mosschief/toddler_bed/output/CUT_LIST.md

# Cut lists

All sizes in inches, generated by `generate.py`.

### Floor bed, side exit

Mattress on the floor, exit toward the foot end like the reference photo.

| Part | Qty | Size (W x H) | Notes |
|---|---:|---|---|
| Front panel A | 1 | 45 1/4" x 14" | knob half |
| Front panel B | 1 | 20" x 14" | socket half |
| Box side (wall) | 2 | 28 1/8" x 12 1/4" | against the nook wall, 1 per box |
| Box side (mattress) | 2 | 28 1/8" x 12 1/4" | faces the mattress; hand cut-out to open the lid |
| Box back | 2 | 5 3/4" x 12 1/4" | screw through into wall studs |
| Box front | 2 | 5 3/4" x 12 1/4" | against the back of the front panel; 4 bolts into it |
| Box floor | 2 | 5 3/4" x 25 1/2" | sits 1" off the floor |
| Box lid | 2 | 5 3/4" x 27 5/8" | piano hinge along the long wall-side edge |

- **Panels:** 2 pieces of 4'x4' (1 x 4'x8' sheet(s) of 3/4" plywood, each cut in half)
- **Heights from floor:** mattress top 5", rail top 14", box lids 13", exit sill 4"
- **Exit opening:** 38" to 54" from the head wall; panel halves join at 44"
- **Head/foot boxes:** 5 3/4" wide outside, 4 1/4" inside, 27 3/4" deep

### Floor bed, side exit, one box

Same as the side-exit bed, but with one wider box at the head end and the mattress against the foot wall.

| Part | Qty | Size (W x H) | Notes |
|---|---:|---|---|
| Front panel A | 1 | 45 1/4" x 14" | knob half |
| Front panel B | 1 | 20" x 14" | socket half |
| Box side (wall) | 1 | 28 1/8" x 12 1/4" | against the nook wall, 1 per box |
| Box side (mattress) | 1 | 28 1/8" x 12 1/4" | faces the mattress; hand cut-out to open the lid |
| Box back | 1 | 10 3/4" x 12 1/4" | screw through into wall studs |
| Box front | 1 | 10 3/4" x 12 1/4" | against the back of the front panel; 4 bolts into it |
| Box floor | 1 | 10 3/4" x 25 1/2" | sits 1" off the floor |
| Box lid | 1 | 10 3/4" x 27 5/8" | piano hinge along the long wall-side edge |
| Foot wall liner | 1 | 28 1/8" x 13" | screw to the foot wall studs; runs into the panel groove |
| Foot block | 1 | 1 1/2" x 6 1/4" | above the mattress; glue + 2 screws to the liner, 2 bolts into the panel |

- **Panels:** 2 pieces of 4'x4' (1 x 4'x8' sheet(s) of 3/4" plywood, each cut in half)
- **Heights from floor:** mattress top 5", rail top 14", box lids 13", exit sill 4"
- **Exit opening:** 38" to 54" from the head wall; panel halves join at 44"
- **Head box:** 10 3/4" wide outside, 9 1/4" inside, 27 3/4" deep; no foot box (mattress against a liner on the foot wall)

### Floor bed, side exit, one box, flush tops

The one-box bed with the box lid and the foot board raised flush with the top of the front panel.

| Part | Qty | Size (W x H) | Notes |
|---|---:|---|---|
| Front panel A | 1 | 45 1/4" x 14" | knob half |
| Front panel B | 1 | 20" x 14" | socket half |
| Box side (wall) | 1 | 28 1/8" x 13 1/4" | against the nook wall, 1 per box |
| Box side (mattress) | 1 | 28 1/8" x 13 1/4" | faces the mattress; hand cut-out to open the lid |
| Box back | 1 | 10 3/4" x 13 1/4" | screw through into wall studs |
| Box front | 1 | 10 3/4" x 13 1/4" | against the back of the front panel; 4 bolts into it |
| Box floor | 1 | 10 3/4" x 25 1/2" | sits 1" off the floor |
| Box lid | 1 | 10 3/4" x 27 5/8" | piano hinge along the long wall-side edge |
| Foot wall liner | 1 | 28 1/8" x 14" | screw to the foot wall studs; runs into the panel groove |
| Foot block | 1 | 1 1/2" x 7 1/4" | above the mattress; glue + 2 screws to the liner, 2 bolts into the panel |

- **Panels:** 2 pieces of 4'x4' (1 x 4'x8' sheet(s) of 3/4" plywood, each cut in half)
- **Heights from floor:** mattress top 5", rail top 14", box lids 14", exit sill 4"
- **Exit opening:** 38" to 54" from the head wall; panel halves join at 44"
- **Head box:** 10 3/4" wide outside, 9 1/4" inside, 27 3/4" deep; no foot box (mattress against a liner on the foot wall)

### Floor bed, side exit, one box, flowers

The flush-top one-box bed with flower cut-outs in the rail instead of slots.

| Part | Qty | Size (W x H) | Notes |
|---|---:|---|---|
| Front panel A | 1 | 45 1/4" x 14" | knob half |
| Front panel B | 1 | 20" x 14" | socket half |
| Box side (wall) | 1 | 28 1/8" x 13 1/4" | against the nook wall, 1 per box |
| Box side (mattress) | 1 | 28 1/8" x 13 1/4" | faces the mattress; hand cut-out to open the lid |
| Box back | 1 | 10 3/4" x 13 1/4" | screw through into wall studs |
| Box front | 1 | 10 3/4" x 13 1/4" | against the back of the front panel; 4 bolts into it |
| Box floor | 1 | 10 3/4" x 25 1/2" | sits 1" off the floor |
| Box lid | 1 | 10 3/4" x 27 5/8" | piano hinge along the long wall-side edge |
| Foot wall liner | 1 | 28 1/8" x 14" | screw to the foot wall studs; runs into the panel groove |
| Foot block | 1 | 1 1/2" x 7 1/4" | above the mattress; glue + 2 screws to the liner, 2 bolts into the panel |

- **Panels:** 2 pieces of 4'x4' (1 x 4'x8' sheet(s) of 3/4" plywood, each cut in half)
- **Heights from floor:** mattress top 5", rail top 14", box lids 14", exit sill 4"
- **Exit opening:** 38" to 54" from the head wall; panel halves join at 44"
- **Head box:** 10 3/4" wide outside, 9 1/4" inside, 27 3/4" deep; no foot box (mattress against a liner on the foot wall)

### Floor bed, side exit, box at the foot

The flush-top one-box bed with the box moved to the foot end and the mattress against the head wall; the exit sits just before the box.

| Part | Qty | Size (W x H) | Notes |
|---|---:|---|---|
| Front panel A | 1 | 42 1/4" x 14" | knob half |
| Front panel B | 1 | 23" x 14" | socket half |
| Box side (wall) | 1 | 28 1/8" x 13 1/4" | against the nook wall, 1 per box |
| Box side (mattress) | 1 | 28 1/8" x 13 1/4" | faces the mattress; hand cut-out to open the lid |
| Box back | 1 | 10 3/4" x 13 1/4" | screw through into wall studs |
| Box front | 1 | 10 3/4" x 13 1/4" | against the back of the front panel; 4 bolts into it |
| Box floor | 1 | 10 3/4" x 25 1/2" | sits 1" off the floor |
| Box lid | 1 | 10 3/4" x 27 5/8" | piano hinge along the long wall-side edge |
| Head wall liner | 1 | 28 1/8" x 14" | screw to the head wall studs; runs into the panel groove |
| Head block | 1 | 1 1/2" x 7 1/4" | above the mattress; glue + 2 screws to the liner, 2 bolts into the panel |

- **Panels:** 2 pieces of 4'x4' (1 x 4'x8' sheet(s) of 3/4" plywood, each cut in half)
- **Heights from floor:** mattress top 5", rail top 14", box lids 14", exit sill 4"
- **Exit opening:** 35" to 51" from the head wall; panel halves join at 41"
- **Foot box:** 10 3/4" wide outside, 9 1/4" inside, 27 3/4" deep; no head box (mattress against a liner on the head wall)

### Floor bed, side exit, box at the foot, trees

The foot-box bed with a staggered row of pine-tree cut-outs instead of slots.

| Part | Qty | Size (W x H) | Notes |
|---|---:|---|---|
| Front panel A | 1 | 42 1/4" x 14" | knob half |
| Front panel B | 1 | 23" x 14" | socket half |
| Box side (wall) | 1 | 28 1/8" x 13 1/4" | against the nook wall, 1 per box |
| Box side (mattress) | 1 | 28 1/8" x 13 1/4" | faces the mattress; hand cut-out to open the lid |
| Box back | 1 | 10 3/4" x 13 1/4" | screw through into wall studs |
| Box front | 1 | 10 3/4" x 13 1/4" | against the back of the front panel; 4 bolts into it |
| Box floor | 1 | 10 3/4" x 25 1/2" | sits 1" off the floor |
| Box lid | 1 | 10 3/4" x 27 5/8" | piano hinge along the long wall-side edge |
| Head wall liner | 1 | 28 1/8" x 14" | screw to the head wall studs; runs into the panel groove |
| Head block | 1 | 1 1/2" x 7 1/4" | above the mattress; glue + 2 screws to the liner, 2 bolts into the panel |

- **Panels:** 2 pieces of 4'x4' (1 x 4'x8' sheet(s) of 3/4" plywood, each cut in half)
- **Heights from floor:** mattress top 5", rail top 14", box lids 14", exit sill 4"
- **Exit opening:** 35" to 51" from the head wall; panel halves join at 41"
- **Foot box:** 10 3/4" wide outside, 9 1/4" inside, 27 3/4" deep; no head box (mattress against a liner on the head wall)

### Floor bed, side exit, box at the foot, ferns

The foot-box bed with a row of fern-frond cut-outs instead of slots.

| Part | Qty | Size (W x H) | Notes |
|---|---:|---|---|
| Front panel A | 1 | 42 1/4" x 14" | knob half |
| Front panel B | 1 | 23" x 14" | socket half |
| Box side (wall) | 1 | 28 1/8" x 13 1/4" | against the nook wall, 1 per box |
| Box side (mattress) | 1 | 28 1/8" x 13 1/4" | faces the mattress; hand cut-out to open the lid |
| Box back | 1 | 10 3/4" x 13 1/4" | screw through into wall studs |
| Box front | 1 | 10 3/4" x 13 1/4" | against the back of the front panel; 4 bolts into it |
| Box floor | 1 | 10 3/4" x 25 1/2" | sits 1" off the floor |
| Box lid | 1 | 10 3/4" x 27 5/8" | piano hinge along the long wall-side edge |
| Head wall liner | 1 | 28 1/8" x 14" | screw to the head wall studs; runs into the panel groove |
| Head block | 1 | 1 1/2" x 7 1/4" | above the mattress; glue + 2 screws to the liner, 2 bolts into the panel |

- **Panels:** 2 pieces of 4'x4' (1 x 4'x8' sheet(s) of 3/4" plywood, each cut in half)
- **Heights from floor:** mattress top 5", rail top 14", box lids 14", exit sill 4"
- **Exit opening:** 35" to 51" from the head wall; panel halves join at 41"
- **Foot box:** 10 3/4" wide outside, 9 1/4" inside, 27 3/4" deep; no head box (mattress against a liner on the head wall)

### Floor bed, centre exit

Mattress on the floor, exit in the middle; the two panel halves are mirror-length and join in the low sill.

| Part | Qty | Size (W x H) | Notes |
|---|---:|---|---|
| Front panel A | 1 | 33 1/4" x 14" | knob half |
| Front panel B | 1 | 32" x 14" | socket half |
| Box side (wall) | 2 | 28 1/8" x 12 1/4" | against the nook wall, 1 per box |
| Box side (mattress) | 2 | 28 1/8" x 12 1/4" | faces the mattress; hand cut-out to open the lid |
| Box back | 2 | 5 3/4" x 12 1/4" | screw through into wall studs |
| Box front | 2 | 5 3/4" x 12 1/4" | against the back of the front panel; 4 bolts into it |
| Box floor | 2 | 5 3/4" x 25 1/2" | sits 1" off the floor |
| Box lid | 2 | 5 3/4" x 27 5/8" | piano hinge along the long wall-side edge |

- **Panels:** 2 pieces of 4'x4' (1 x 4'x8' sheet(s) of 3/4" plywood, each cut in half)
- **Heights from floor:** mattress top 5", rail top 14", box lids 13", exit sill 4"
- **Exit opening:** 24" to 40" from the head wall; panel halves join at 32"
- **Head/foot boxes:** 5 3/4" wide outside, 4 1/4" inside, 27 3/4" deep

### Raised bed over IKEA drawers

Mattress on a plywood deck over two small IKEA HEMNES underbed boxes, with plywood drawer faces; centre exit.

| Part | Qty | Size (W x H) | Notes |
|---|---:|---|---|
| Front panel A | 1 | 33 1/4" x 22 5/8" | knob half |
| Front panel B | 1 | 32" x 22 5/8" | socket half |
| Box side (wall) | 2 | 28 1/8" x 20 7/8" | against the nook wall, 1 per box |
| Box side (mattress) | 2 | 28 1/8" x 20 7/8" | faces the mattress; hand cut-out to open the lid |
| Box back | 2 | 5 3/4" x 20 7/8" | screw through into wall studs |
| Box front | 2 | 5 3/4" x 20 7/8" | against the back of the front panel; 4 bolts into it |
| Box floor | 2 | 5 3/4" x 25 1/2" | sits 1" off the floor |
| Box lid | 2 | 5 3/4" x 27 5/8" | piano hinge along the long wall-side edge |
| Deck ledger (box side) | 2 | 27 3/4" x 1 1/2" | screwed to the mattress-side face of each box |
| Deck | 2 | 26 1/4" x 27 3/4" | mattress platform, two halves |
| Centre divider | 1 | 28 1/2" x 7 7/8" | front edge flush with the panel face |
| Deck ledger (wall) | 2 | 25 7/8" x 1 1/2" | screw into wall studs at the back |
| Drawer face | 2 | 25 5/8" x 7 3/8" | screw to the IKEA box from inside |

- **Panels:** 5 pieces of 4'x4' (3 x 4'x8' sheet(s) of 3/4" plywood, each cut in half)
- **Heights from floor:** mattress top 13 5/8", rail top 22 5/8", box lids 21 5/8", exit sill 12 5/8"
- **Exit opening:** 24" to 40" from the head wall; panel halves join at 32"
- **Head/foot boxes:** 5 3/4" wide outside, 4 1/4" inside, 27 3/4" deep
