mosschief/toddler_bed/hardware/lid_hinges/lid_hidden_hinge_end_view.png

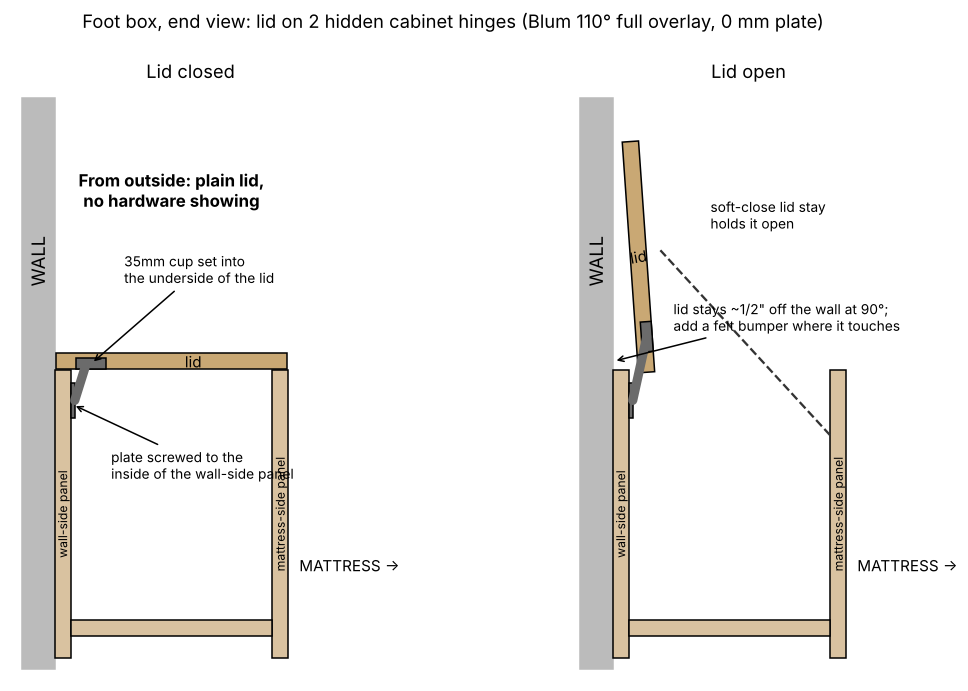
hardware/lid_hinges/lid_hidden_hinge_end_view.png
