mosschief/toddler_bed/hardware/lid_hinges/lid_hinge_cups.png

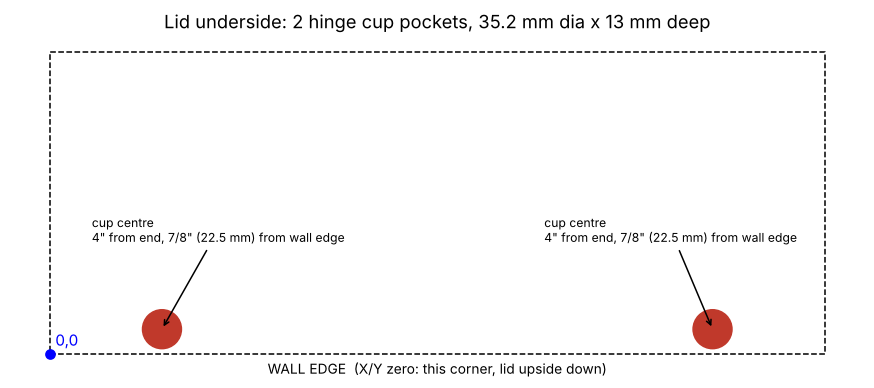
hardware/lid_hinges/lid_hinge_cups.png
