mosschief/toddler_bed/output/v1_side_exit/dogbone_detail.png

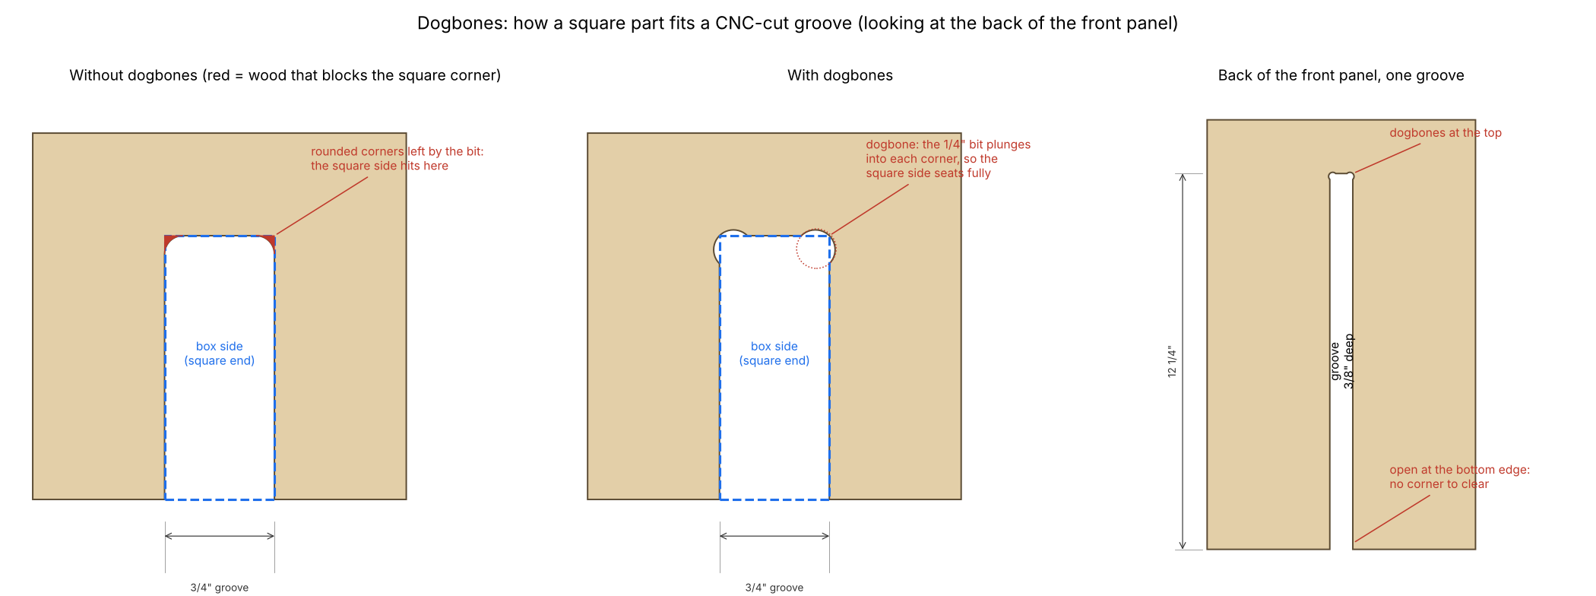
output/v1_side_exit/dogbone_detail.png
