mosschief/toddler_bed/hardware/lid_hinges/lid_hinge_cups.dxf

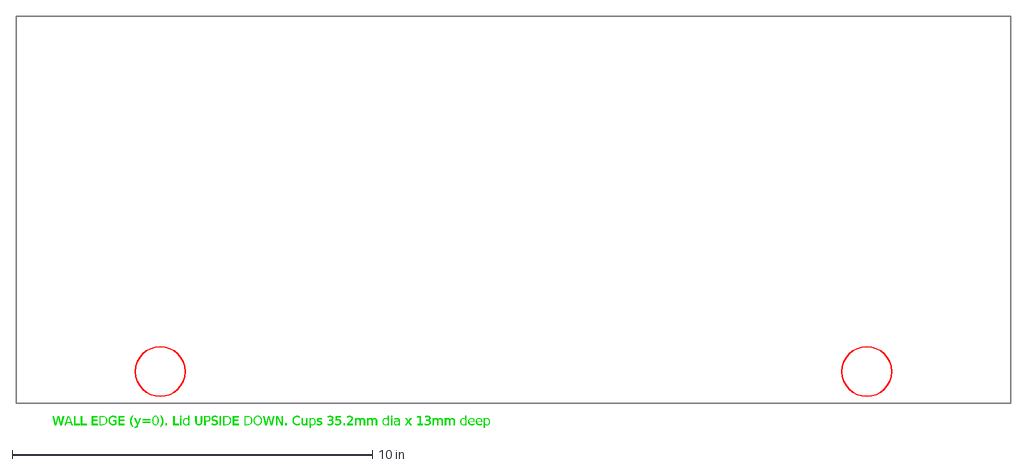
[picture p42: CAD file, 2026-10-31]
hardware/lid_hinges/lid_hinge_cups.dxf
WALL EDGE (y=0). Lid UPSIDE DOWN. Cups 35.2mm dia x 13mm deep
