mosschief/toddler_bed/output/v1_side_exit/parts/front_panel_b.dxf

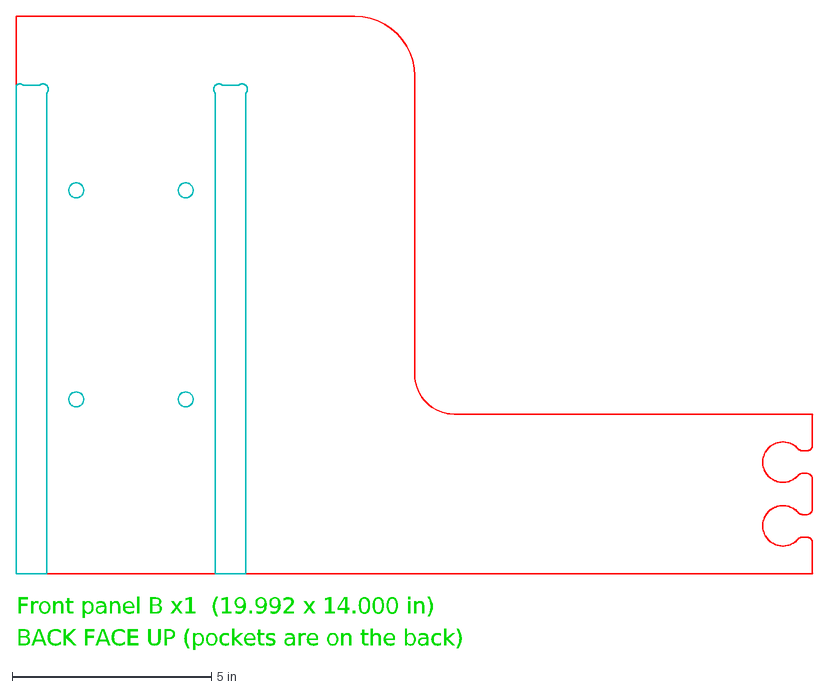
[picture p43: CAD file, 2026-10-17]
output/v1_side_exit/parts/front_panel_b.dxf
BACK FACE UP (pockets are on the back)
Front panel B x1 (19.992 x 14.000 in)
