mosschief/toddler_bed/output/v1_side_exit/v1_side_exit.step

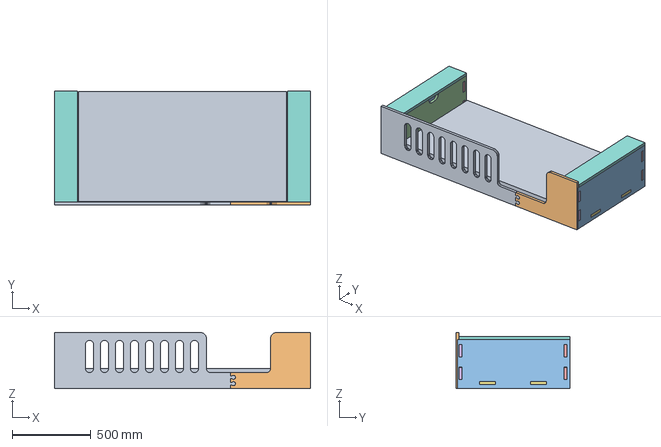
[picture p44: CAD file, 2026-10-17]
output/v1_side_exit/v1_side_exit.step
1625.6 x 723.9 x 355.6 mm
