mosschief/toddler_bed/output/v1b_side_exit_one_box/parts/box_front.dxf

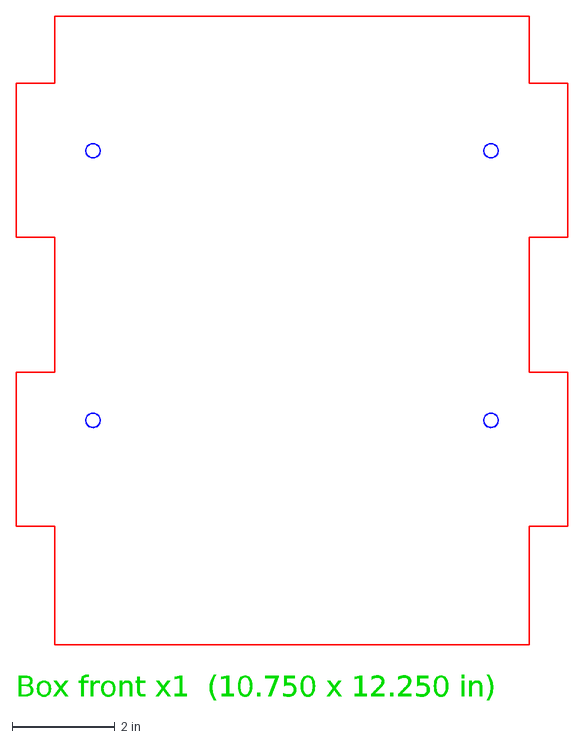
[picture p45: CAD file, 2026-10-17]
output/v1b_side_exit_one_box/parts/box_front.dxf
Box front x1 (10.750 x 12.250 in)
