mosschief/toddler_bed/output/v1b_side_exit_one_box/v1b_side_exit_one_box.step

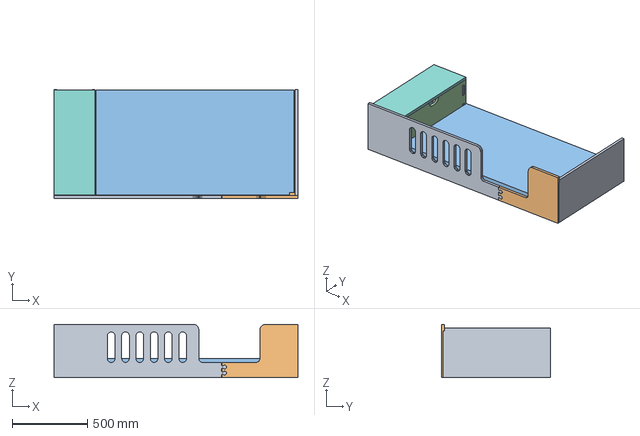
[picture p46: CAD file, 2026-10-17]
output/v1b_side_exit_one_box/v1b_side_exit_one_box.step
1625.6 x 723.9 x 355.6 mm
