mosschief/toddler_bed/output/v1c_side_exit_one_box_flush/v1c_side_exit_one_box_flush.step

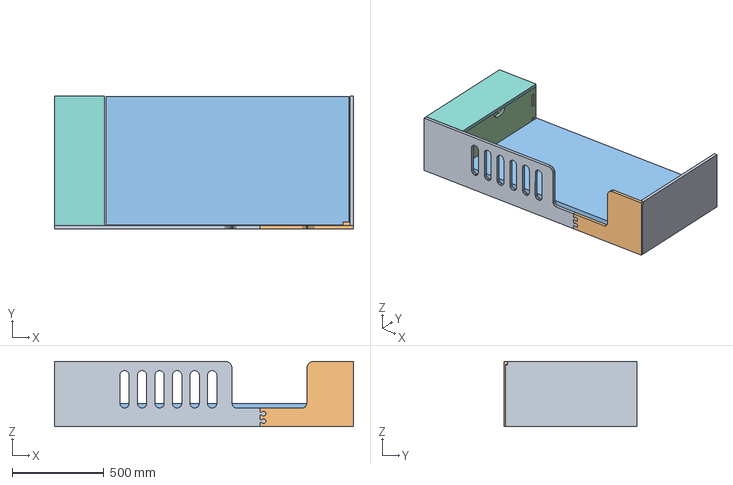
[picture p47: CAD file, 2026-10-17]
output/v1c_side_exit_one_box_flush/v1c_side_exit_one_box_flush.step
1625.6 x 723.9 x 355.6 mm
