mosschief/toddler_bed/output/v1d_side_exit_one_box_flowers/parts/box_side_wall.dxf

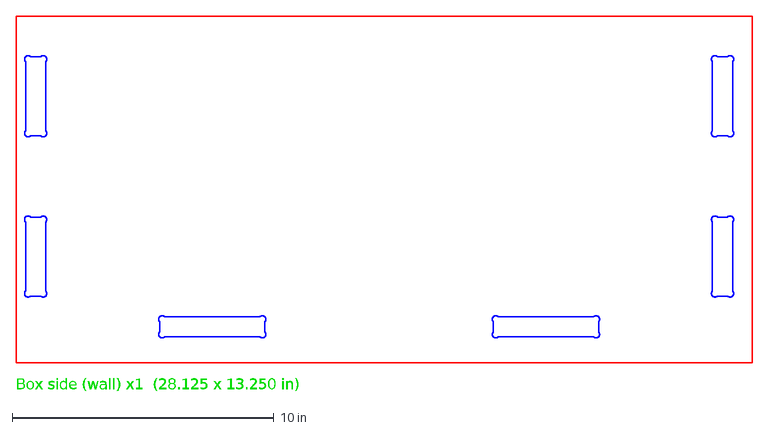
[picture p48: CAD file, 2026-10-17]
output/v1d_side_exit_one_box_flowers/parts/box_side_wall.dxf
Box side (wall) x1 (28.125 x 13.250 in)
