mosschief/toddler_bed/output/v1e_side_exit_foot_box/v1e_side_exit_foot_box.step

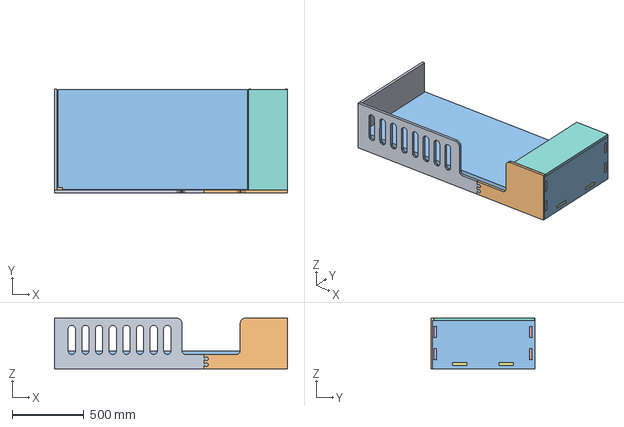
[picture p50: CAD file, 2026-10-17]
output/v1e_side_exit_foot_box/v1e_side_exit_foot_box.step
1625.6 x 723.9 x 355.6 mm
