mosschief/toddler_bed/output/v1f_side_exit_foot_box_trees/parts/box_lid.dxf

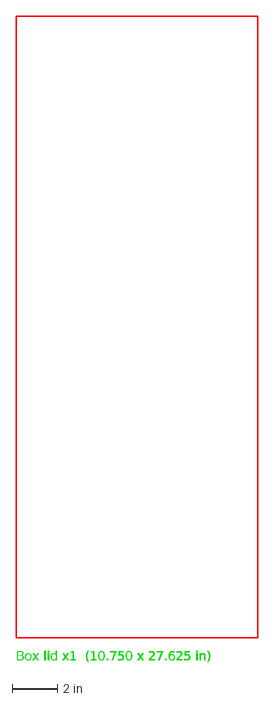
[picture p51: CAD file, 2026-10-17]
output/v1f_side_exit_foot_box_trees/parts/box_lid.dxf
Box lid x1 (10.750 x 27.625 in)
