mosschief/toddler_bed/output/v1g_side_exit_foot_box_ferns/parts/box_back.dxf

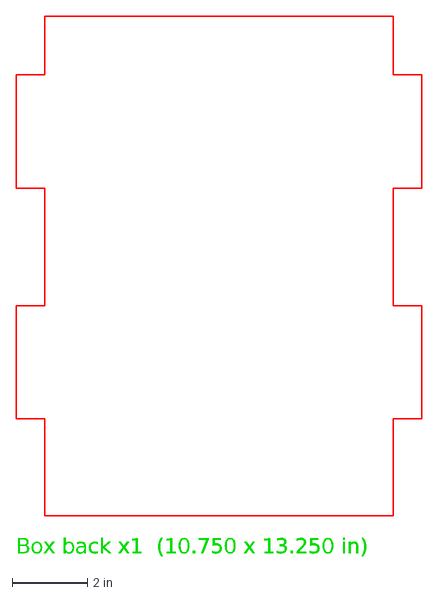
[picture p52: CAD file, 2026-10-17]
output/v1g_side_exit_foot_box_ferns/parts/box_back.dxf
Box back x1 (10.750 x 13.250 in)
