mosschief/toddler_bed/output/v1g_side_exit_foot_box_ferns/v1g_side_exit_foot_box_ferns.step

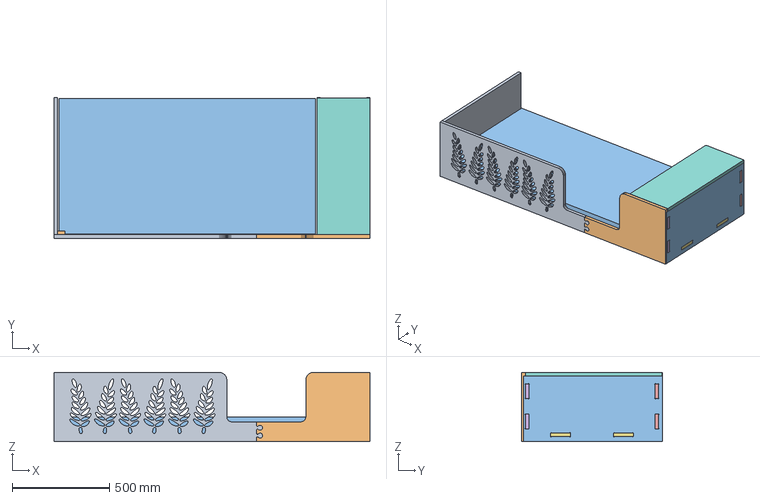
[picture p53: CAD file, 2026-10-17]
output/v1g_side_exit_foot_box_ferns/v1g_side_exit_foot_box_ferns.step
1625.6 x 723.9 x 355.6 mm
