mosschief/toddler_bed/output/v2_center_exit/parts/box_front.dxf

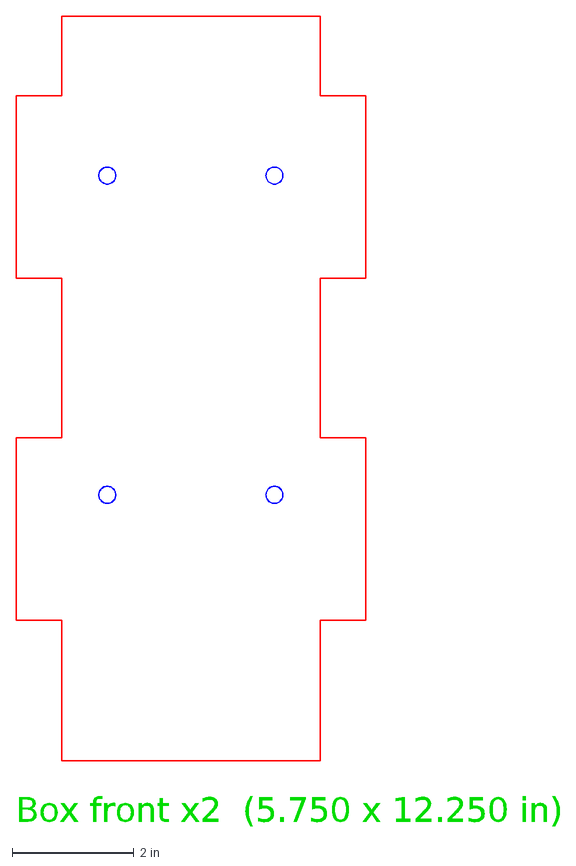
[picture p54: CAD file, 2026-10-17]
output/v2_center_exit/parts/box_front.dxf
Box front x2 (5.750 x 12.250 in)
