mosschief/toddler_bed/output/v3_raised_drawers/parts/box_side_wall.dxf

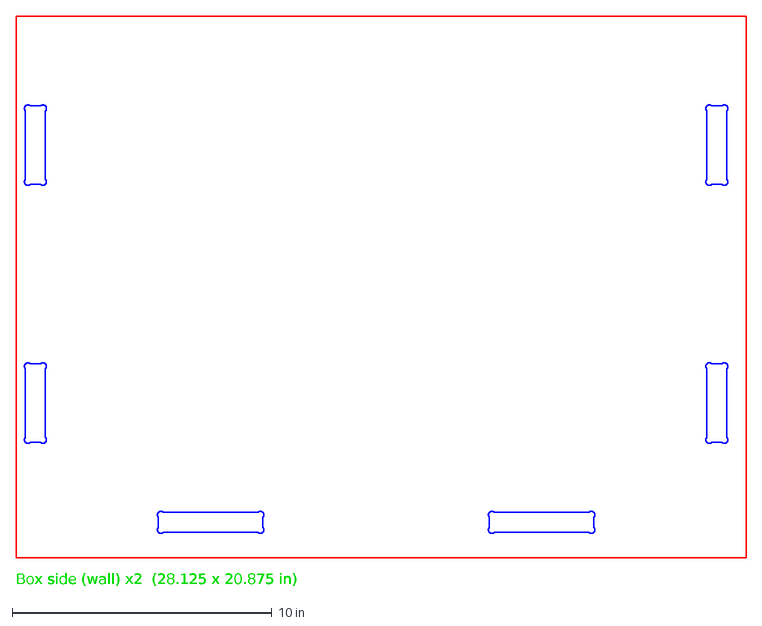
[picture p55: CAD file, 2026-10-17]
output/v3_raised_drawers/parts/box_side_wall.dxf
Box side (wall) x2 (28.125 x 20.875 in)
