mosschief/toddler_bed/output/v1b_side_exit_one_box/parts/foot_wall_liner.dxf

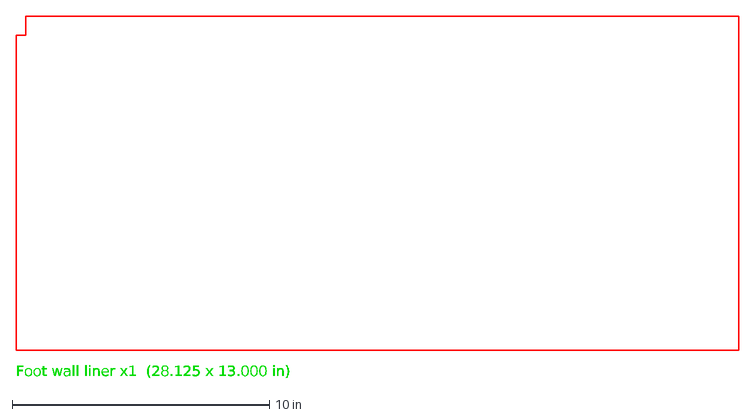
[picture p57: CAD file, 2026-10-17]
output/v1b_side_exit_one_box/parts/foot_wall_liner.dxf
Foot wall liner x1 (28.125 x 13.000 in)
