mosschief/toddler_bed/output/v1e_side_exit_foot_box/parts/box_side_wall.dxf

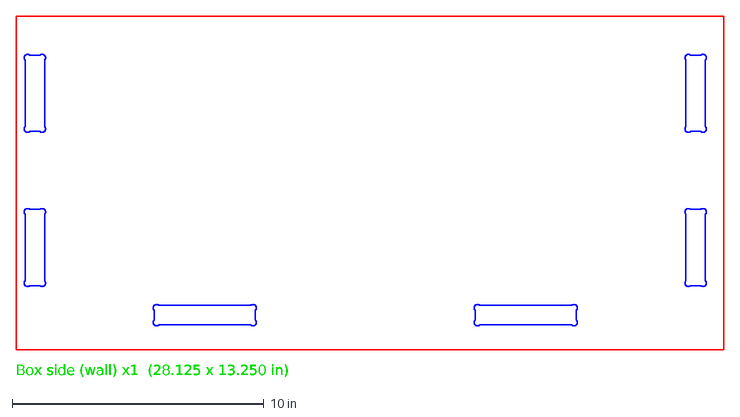
[picture p59: CAD file, 2026-10-17]
output/v1e_side_exit_foot_box/parts/box_side_wall.dxf
Box side (wall) x1 (28.125 x 13.250 in)
