mosschief/toddler_bed/output/v1f_side_exit_foot_box_trees/parts/box_side_mattress.dxf

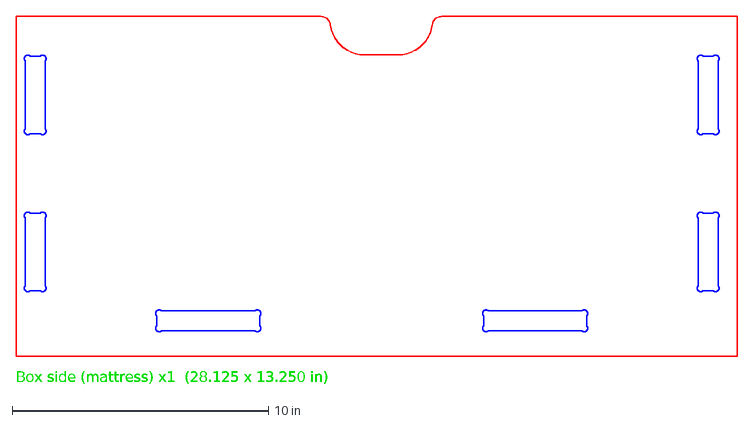
[picture p60: CAD file, 2026-10-17]
output/v1f_side_exit_foot_box_trees/parts/box_side_mattress.dxf
Box side (mattress) x1 (28.125 x 13.250 in)
