mosschief/toddler_bed/output/v2_center_exit/parts/front_panel_b.dxf

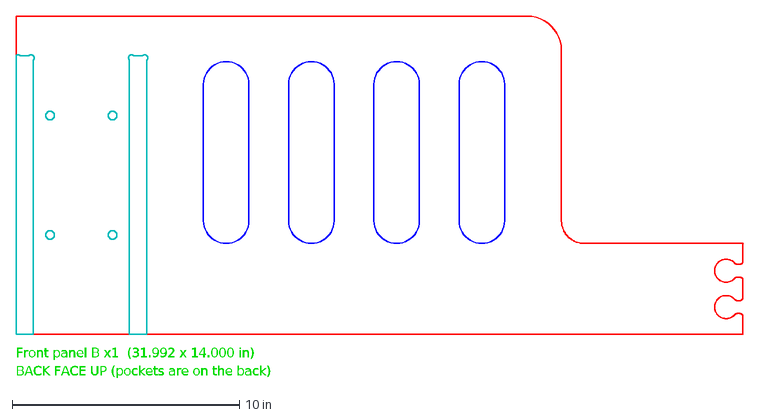
[picture p62: CAD file, 2026-10-17]
output/v2_center_exit/parts/front_panel_b.dxf
BACK FACE UP (pockets are on the back)
Front panel B x1 (31.992 x 14.000 in)
