mosschief/toddler_bed/output/v3_raised_drawers/parts/box_back.dxf

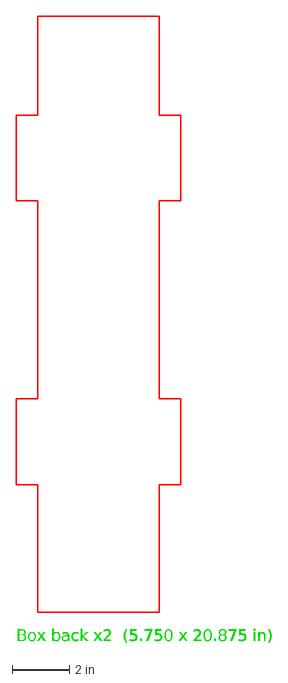
[picture p63: CAD file, 2026-10-17]
output/v3_raised_drawers/parts/box_back.dxf
Box back x2 (5.750 x 20.875 in)
