mosschief/toddler_bed/output/v1_side_exit/parts/box_floor.dxf

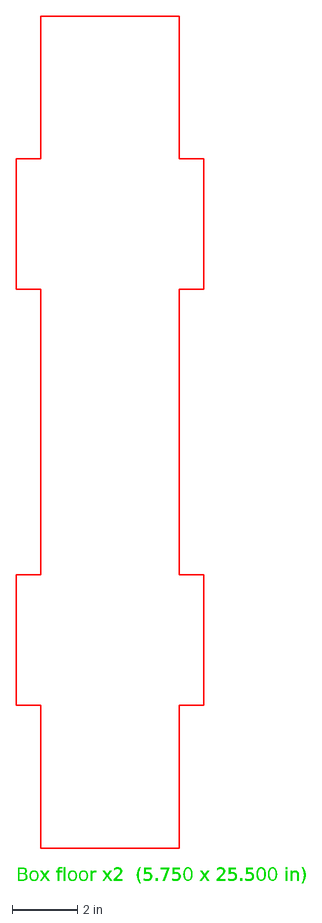
[picture p64: CAD file, 2026-10-17]
output/v1_side_exit/parts/box_floor.dxf
Box floor x2 (5.750 x 25.500 in)
