mosschief/toddler_bed/output/v1d_side_exit_one_box_flowers/parts/front_panel_b.dxf

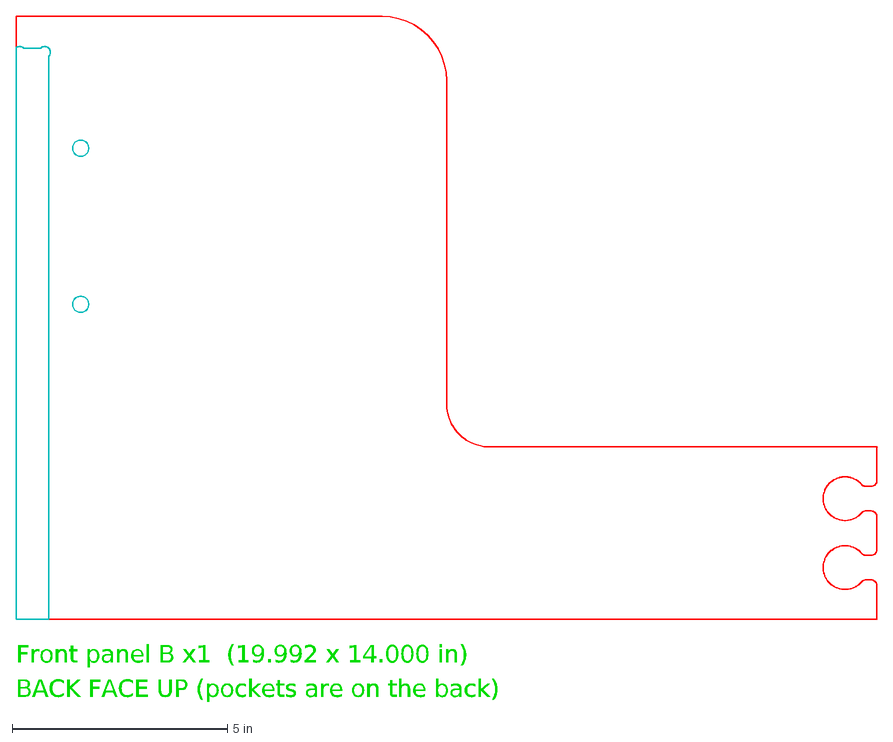
[picture p67: CAD file, 2026-10-17]
output/v1d_side_exit_one_box_flowers/parts/front_panel_b.dxf
BACK FACE UP (pockets are on the back)
Front panel B x1 (19.992 x 14.000 in)
