mosschief/toddler_bed/output/v2_center_exit/parts/box_floor.dxf

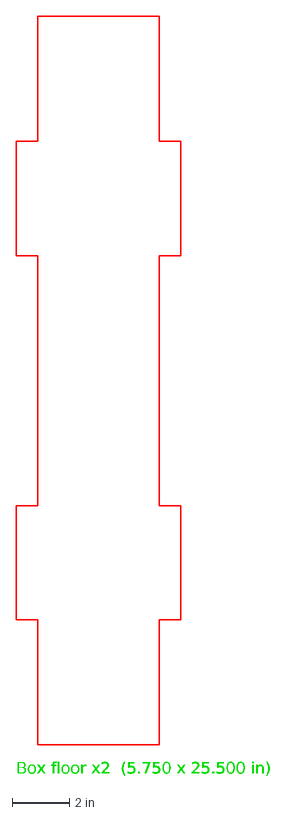
[picture p70: CAD file, 2026-10-17]
output/v2_center_exit/parts/box_floor.dxf
Box floor x2 (5.750 x 25.500 in)
