mosschief/toddler_bed/output/v3_raised_drawers/parts/centre_divider.dxf

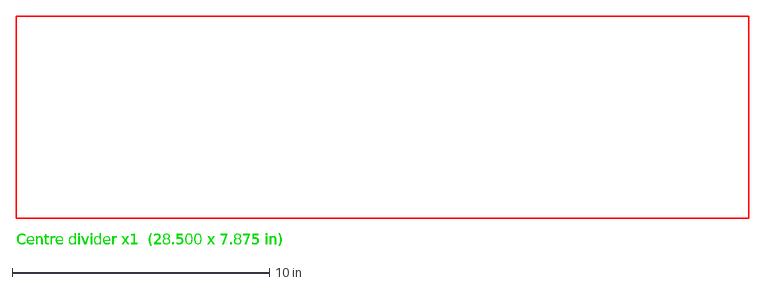
[picture p71: CAD file, 2026-10-17]
output/v3_raised_drawers/parts/centre_divider.dxf
Centre divider x1 (28.500 x 7.875 in)
