mosschief/toddler_bed/output/v1b_side_exit_one_box/parts/foot_block.dxf

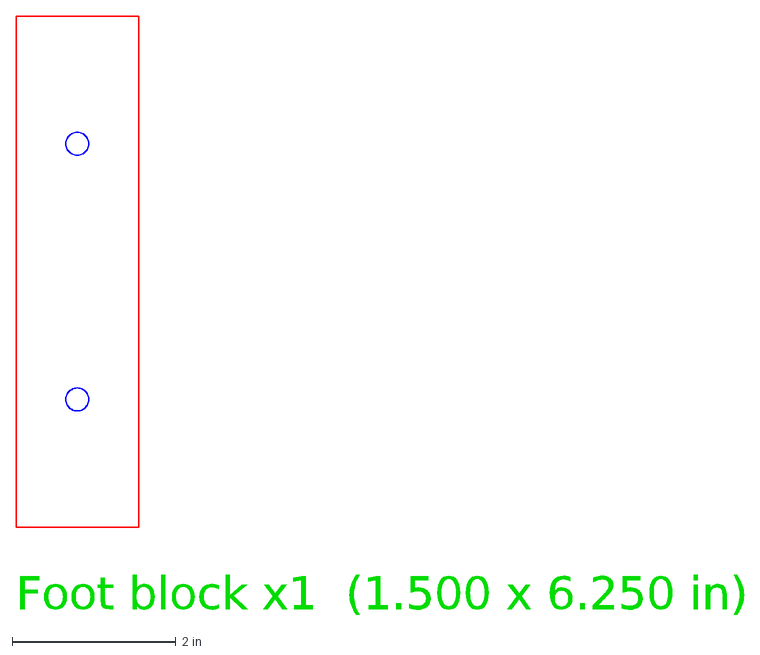
[picture p72: CAD file, 2026-10-17]
output/v1b_side_exit_one_box/parts/foot_block.dxf
Foot block x1 (1.500 x 6.250 in)
