mosschief/toddler_bed/output/v1d_side_exit_one_box_flowers/parts/foot_block.dxf

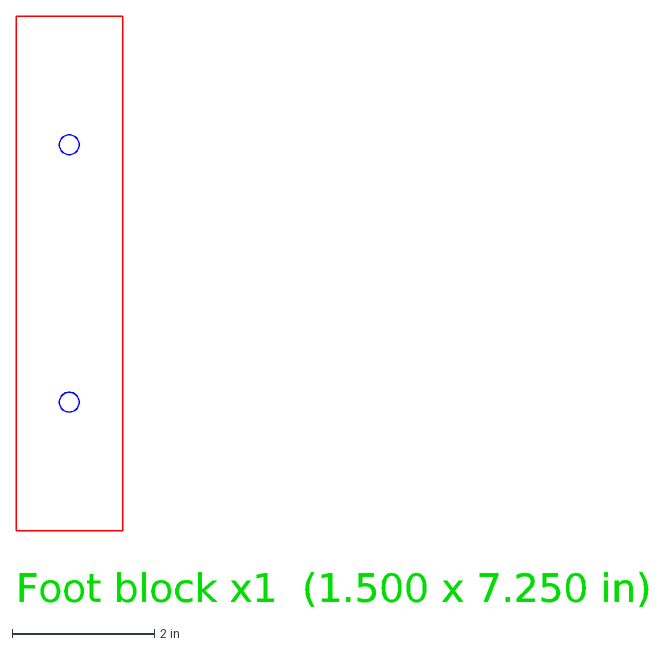
[picture p74: CAD file, 2026-10-17]
output/v1d_side_exit_one_box_flowers/parts/foot_block.dxf
Foot block x1 (1.500 x 7.250 in)
