mosschief/toddler_bed/output/v1e_side_exit_foot_box/parts/box_front.dxf

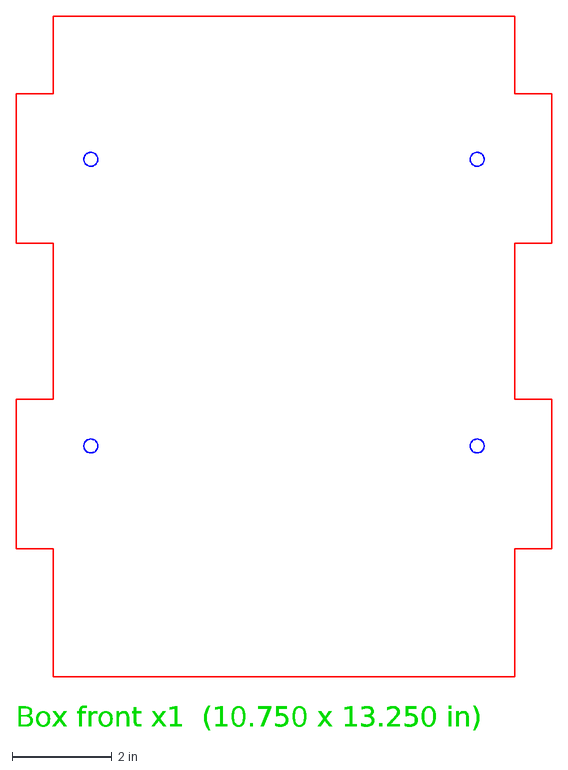
[picture p75: CAD file, 2026-10-17]
output/v1e_side_exit_foot_box/parts/box_front.dxf
Box front x1 (10.750 x 13.250 in)
