mosschief/toddler_bed/output/v2_center_exit/parts/front_panel_a.dxf

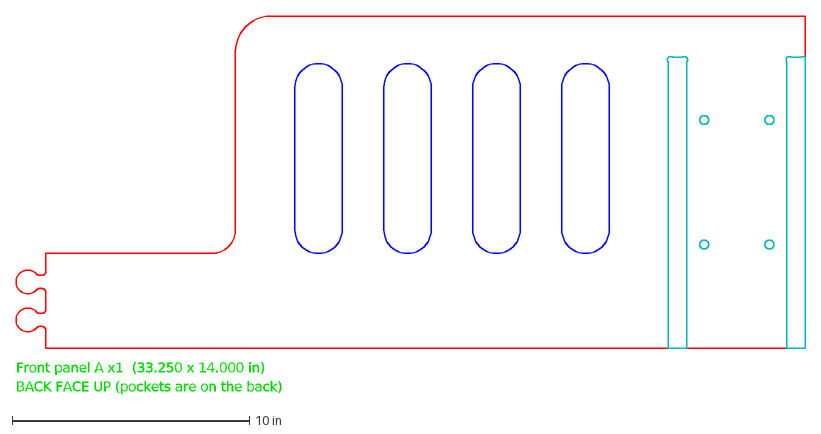
[picture p77: CAD file, 2026-10-17]
output/v2_center_exit/parts/front_panel_a.dxf
BACK FACE UP (pockets are on the back)
Front panel A x1 (33.250 x 14.000 in)
