mosschief/toddler_bed/output/v3_raised_drawers/parts/box_side_mattress.dxf

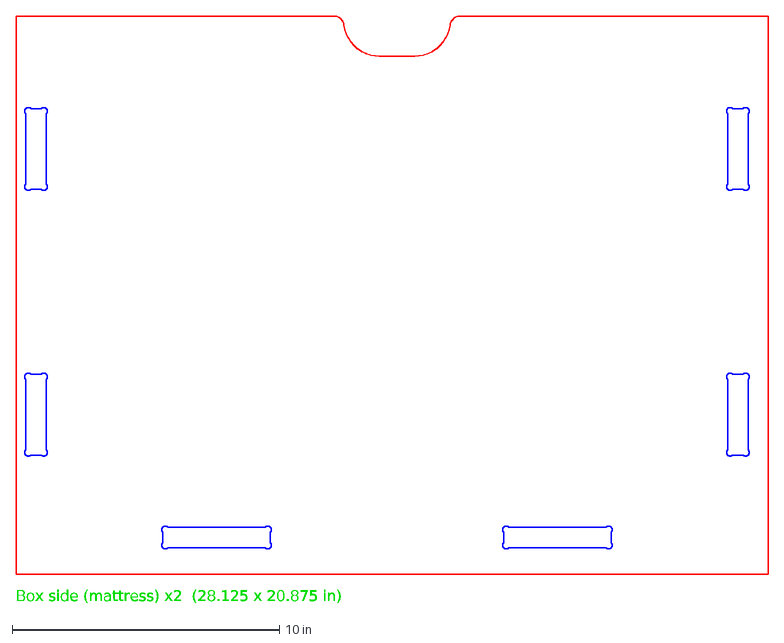
[picture p78: CAD file, 2026-10-17]
output/v3_raised_drawers/parts/box_side_mattress.dxf
Box side (mattress) x2 (28.125 x 20.875 in)
