mosschief/toddler_bed/output/v1b_side_exit_one_box/parts/box_back.dxf

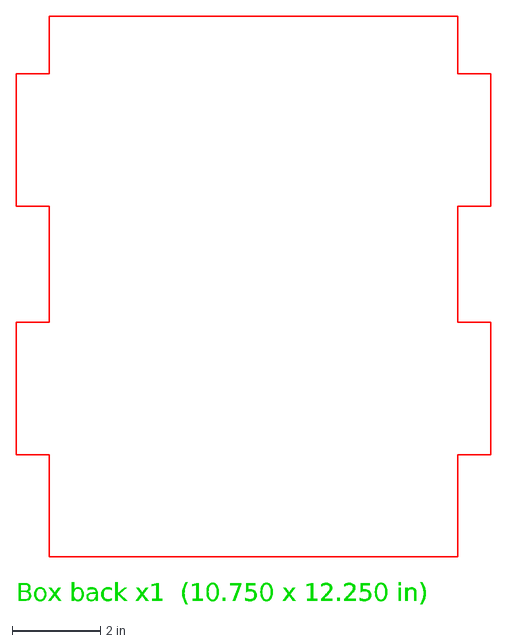
[picture p80: CAD file, 2026-10-17]
output/v1b_side_exit_one_box/parts/box_back.dxf
Box back x1 (10.750 x 12.250 in)
