mosschief/toddler_bed/output/v1c_side_exit_one_box_flush/parts/box_floor.dxf

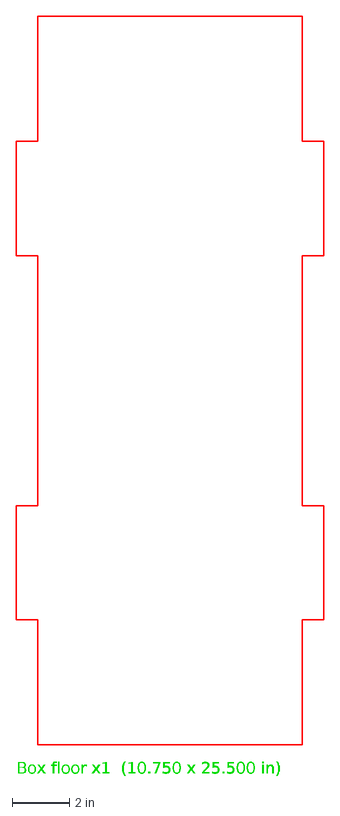
[picture p81: CAD file, 2026-10-17]
output/v1c_side_exit_one_box_flush/parts/box_floor.dxf
Box floor x1 (10.750 x 25.500 in)
