mosschief/toddler_bed/output/v1d_side_exit_one_box_flowers/parts/box_back.dxf

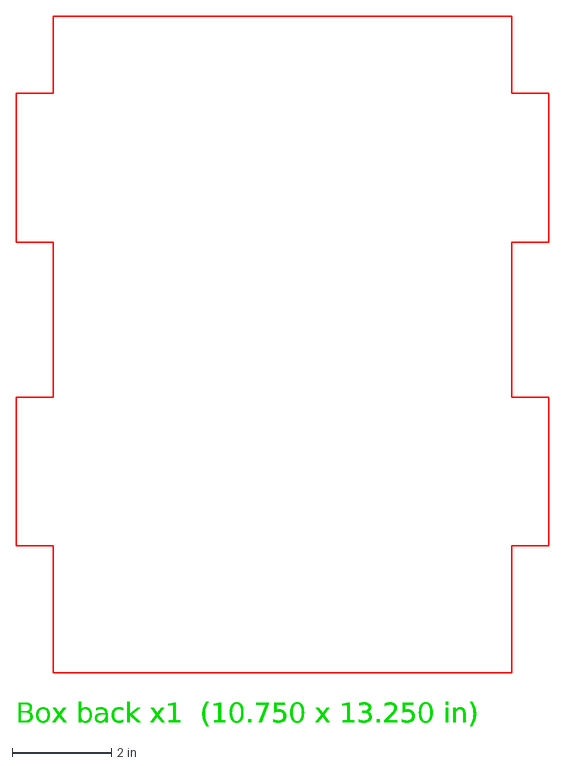
[picture p82: CAD file, 2026-10-17]
output/v1d_side_exit_one_box_flowers/parts/box_back.dxf
Box back x1 (10.750 x 13.250 in)
