mosschief/toddler_bed/output/v2_center_exit/parts/box_side_wall.dxf

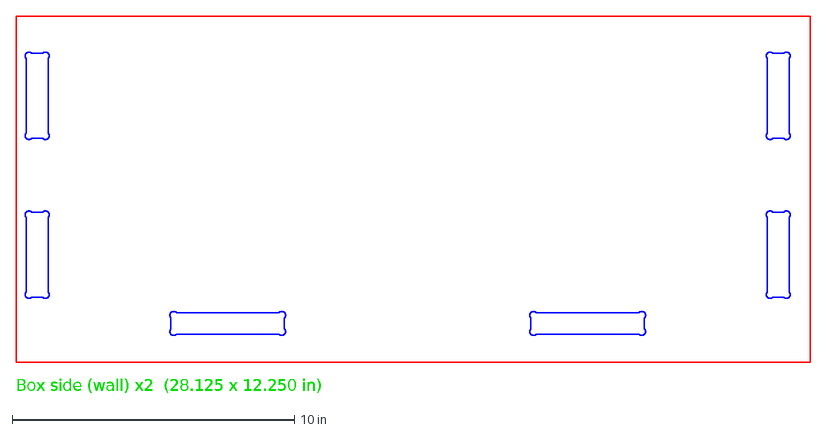
[picture p84: CAD file, 2026-10-17]
output/v2_center_exit/parts/box_side_wall.dxf
Box side (wall) x2 (28.125 x 12.250 in)
