mosschief/toddler_bed/output/v3_raised_drawers/parts/box_front.dxf

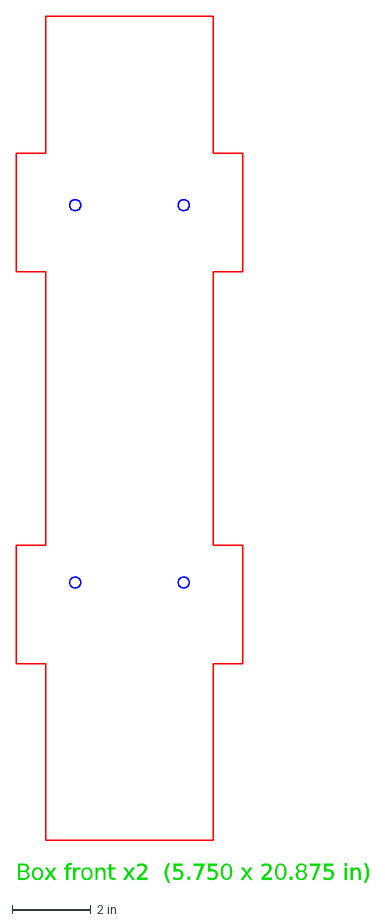
[picture p85: CAD file, 2026-10-17]
output/v3_raised_drawers/parts/box_front.dxf
Box front x2 (5.750 x 20.875 in)
