mosschief/toddler_bed/output/v1c_side_exit_one_box_flush/parts/foot_wall_liner.dxf

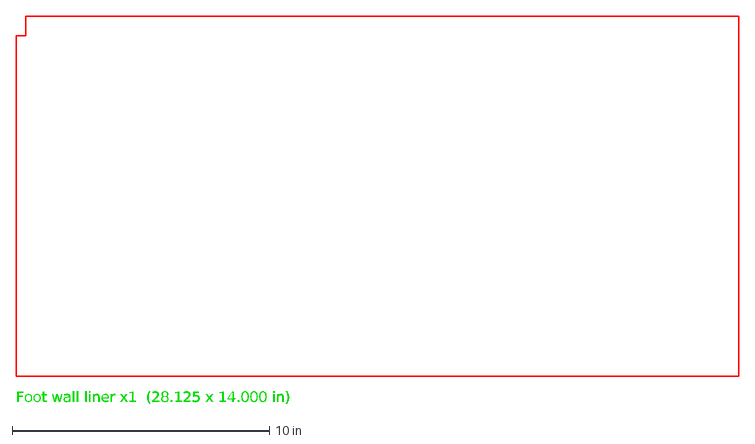
[picture p87: CAD file, 2026-10-17]
output/v1c_side_exit_one_box_flush/parts/foot_wall_liner.dxf
Foot wall liner x1 (28.125 x 14.000 in)
