mosschief/toddler_bed/output/v1e_side_exit_foot_box/parts/box_back.dxf

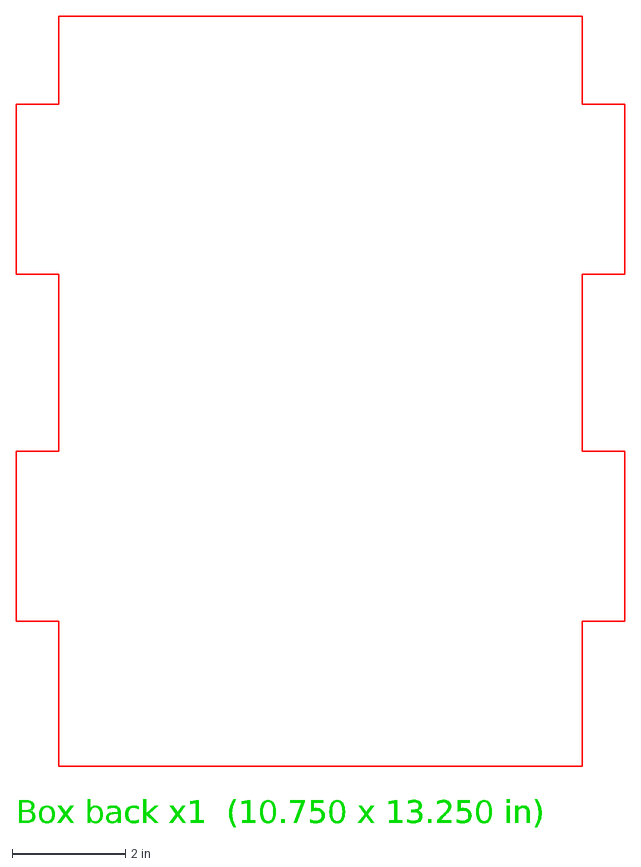
[picture p88: CAD file, 2026-10-17]
output/v1e_side_exit_foot_box/parts/box_back.dxf
Box back x1 (10.750 x 13.250 in)
