mosschief/toddler_bed/output/v2_center_exit/parts/box_back.dxf

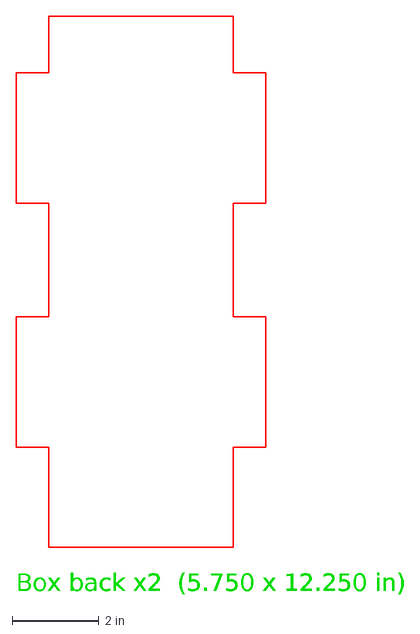
[picture p90: CAD file, 2026-10-17]
output/v2_center_exit/parts/box_back.dxf
Box back x2 (5.750 x 12.250 in)
