mosschief/toddler_bed/output/v3_raised_drawers/parts/deck.dxf

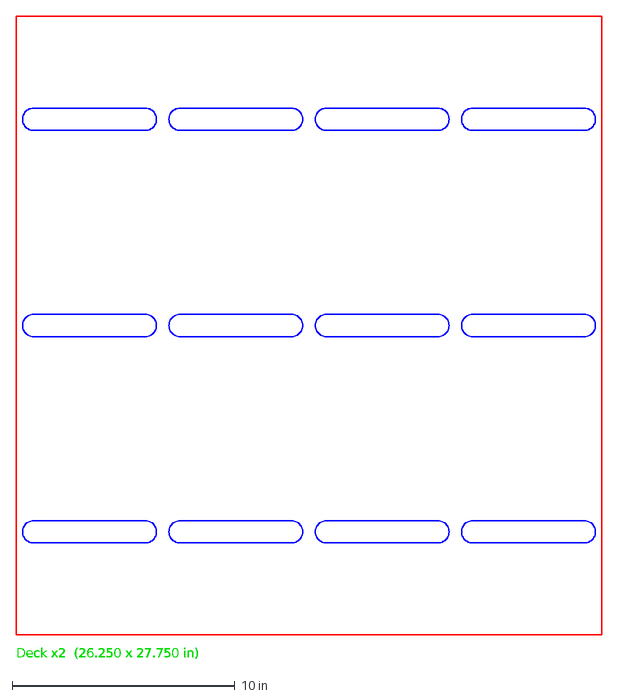
[picture p91: CAD file, 2026-10-17]
output/v3_raised_drawers/parts/deck.dxf
Deck x2 (26.250 x 27.750 in)
