mosschief/toddler_bed/output/v1_side_exit/parts/box_lid.dxf

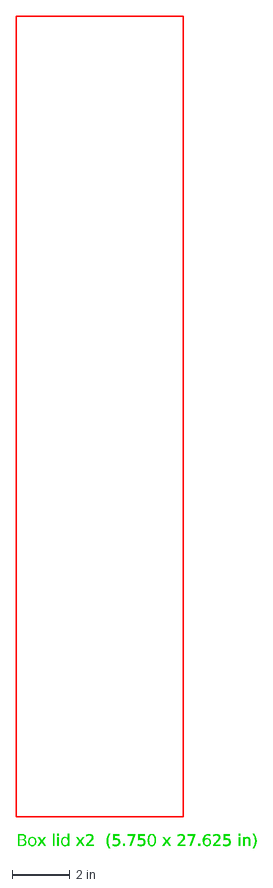
[picture p92: CAD file, 2026-10-17]
output/v1_side_exit/parts/box_lid.dxf
Box lid x2 (5.750 x 27.625 in)
