mosschief/toddler_bed/output/v1c_side_exit_one_box_flush/parts/box_side_wall.dxf

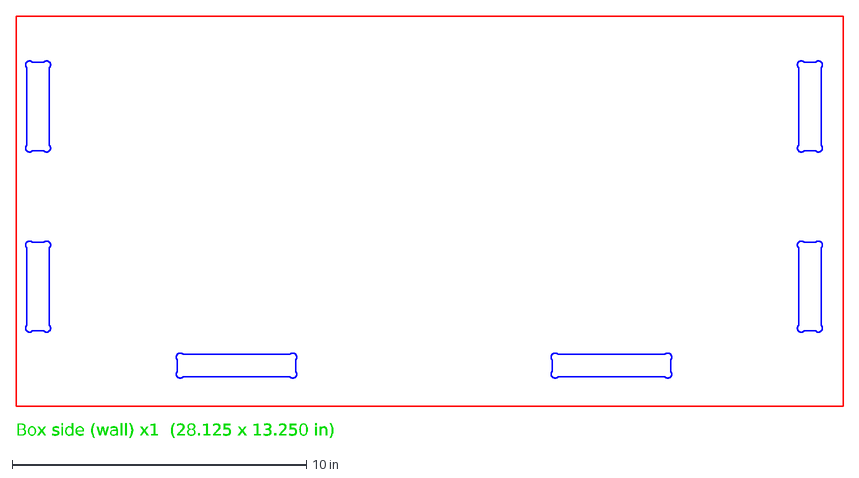
[picture p93: CAD file, 2026-10-17]
output/v1c_side_exit_one_box_flush/parts/box_side_wall.dxf
Box side (wall) x1 (28.125 x 13.250 in)
