mosschief/toddler_bed/output/v1f_side_exit_foot_box_trees/parts/box_back.dxf

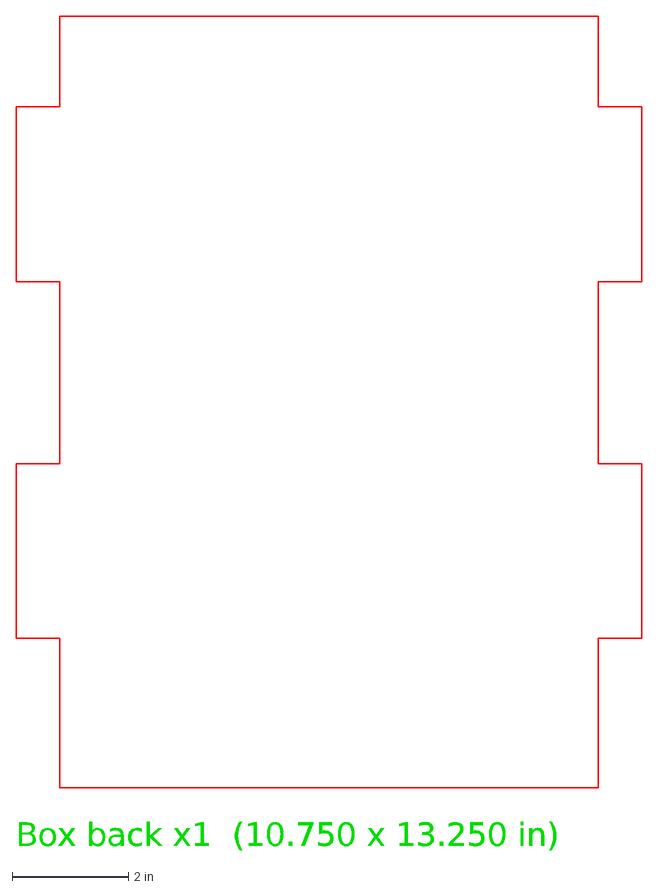
[picture p95: CAD file, 2026-10-17]
output/v1f_side_exit_foot_box_trees/parts/box_back.dxf
Box back x1 (10.750 x 13.250 in)
