mosschief/toddler_bed/output/v2_center_exit/parts/box_side_mattress.dxf

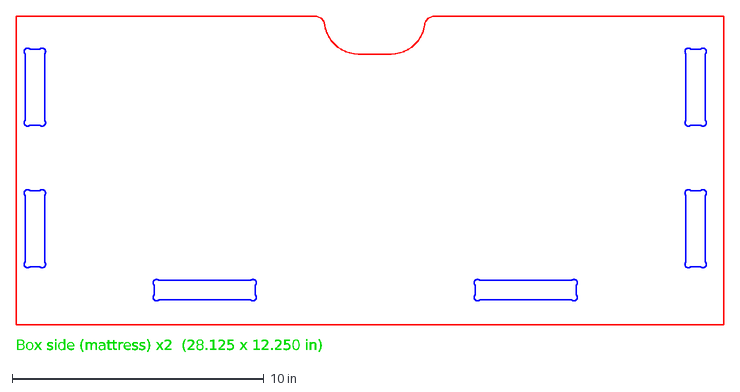
[picture p96: CAD file, 2026-10-17]
output/v2_center_exit/parts/box_side_mattress.dxf
Box side (mattress) x2 (28.125 x 12.250 in)
