mosschief/toddler_bed/output/v3_raised_drawers/parts/drawer_face.dxf

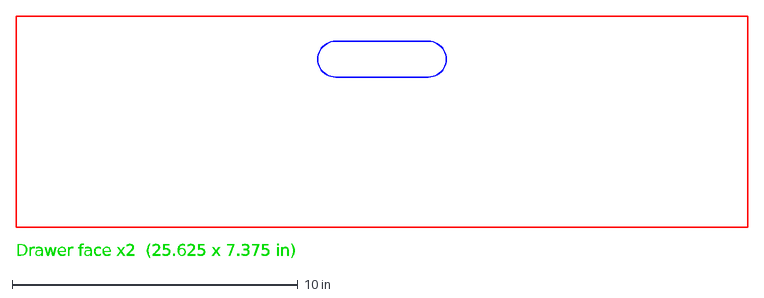
[picture p97: CAD file, 2026-10-17]
output/v3_raised_drawers/parts/drawer_face.dxf
Drawer face x2 (25.625 x 7.375 in)
