mosschief/toddler_bed/output/v1_side_exit/parts/box_side_mattress.dxf

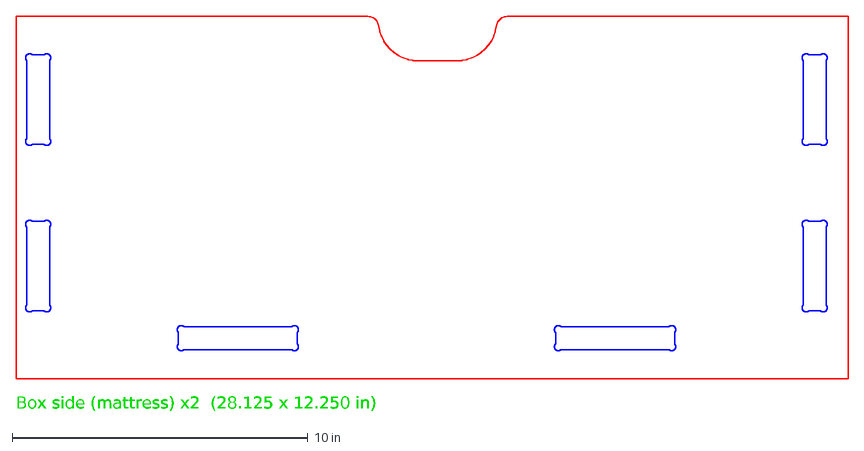
[picture p98: CAD file, 2026-10-17]
output/v1_side_exit/parts/box_side_mattress.dxf
Box side (mattress) x2 (28.125 x 12.250 in)
