mosschief/toddler_bed/output/v1b_side_exit_one_box/parts/box_side_mattress.dxf

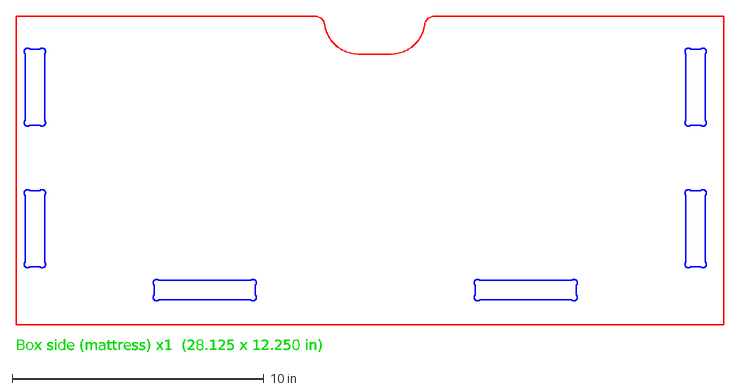
[picture p99: CAD file, 2026-10-17]
output/v1b_side_exit_one_box/parts/box_side_mattress.dxf
Box side (mattress) x1 (28.125 x 12.250 in)
