mosschief/toddler_bed/output/v1f_side_exit_foot_box_trees/parts/head_block.dxf

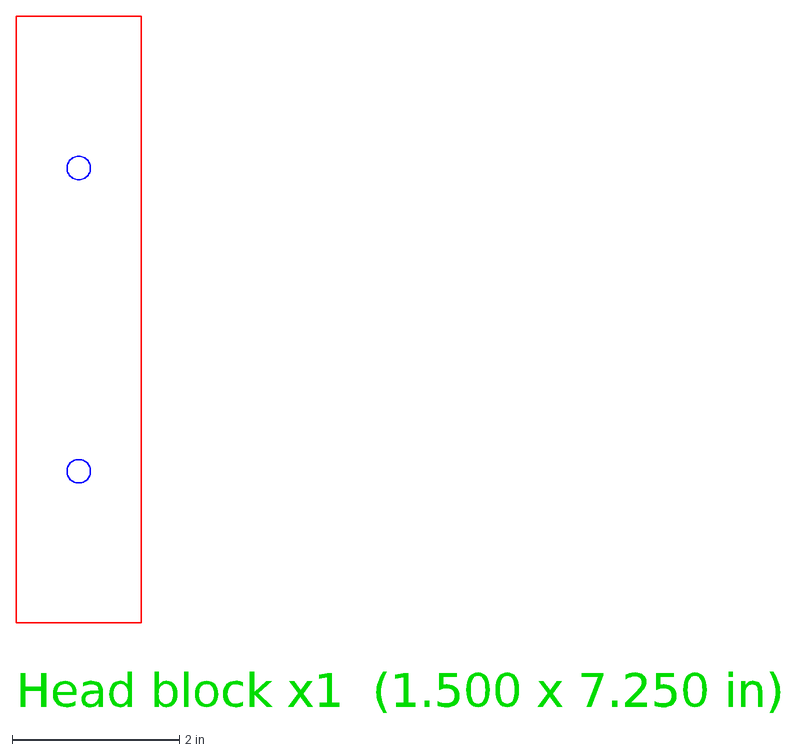
[picture p102: CAD file, 2026-10-17]
output/v1f_side_exit_foot_box_trees/parts/head_block.dxf
Head block x1 (1.500 x 7.250 in)
