mosschief/toddler_bed/output/v1g_side_exit_foot_box_ferns/parts/front_panel_b.dxf

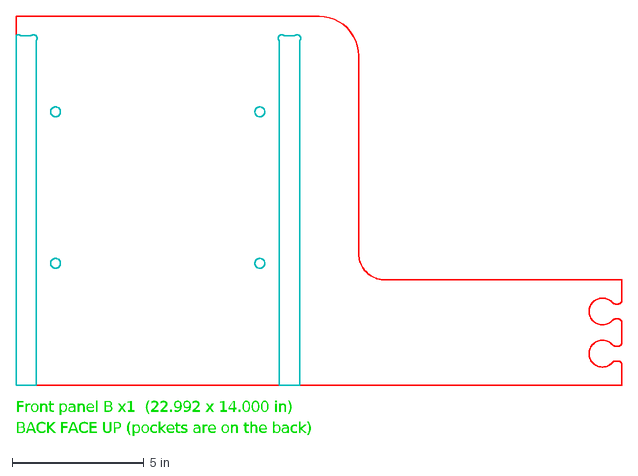
[picture p103: CAD file, 2026-10-17]
output/v1g_side_exit_foot_box_ferns/parts/front_panel_b.dxf
BACK FACE UP (pockets are on the back)
Front panel B x1 (22.992 x 14.000 in)
