mosschief/toddler_bed/output/v2_center_exit/parts/box_lid.dxf

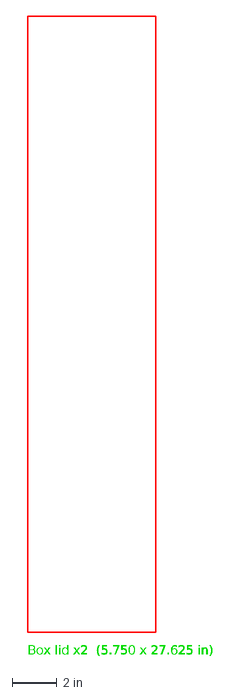
[picture p104: CAD file, 2026-10-17]
output/v2_center_exit/parts/box_lid.dxf
Box lid x2 (5.750 x 27.625 in)
