mosschief/toddler_bed/output/v3_raised_drawers/parts/front_panel_b.dxf

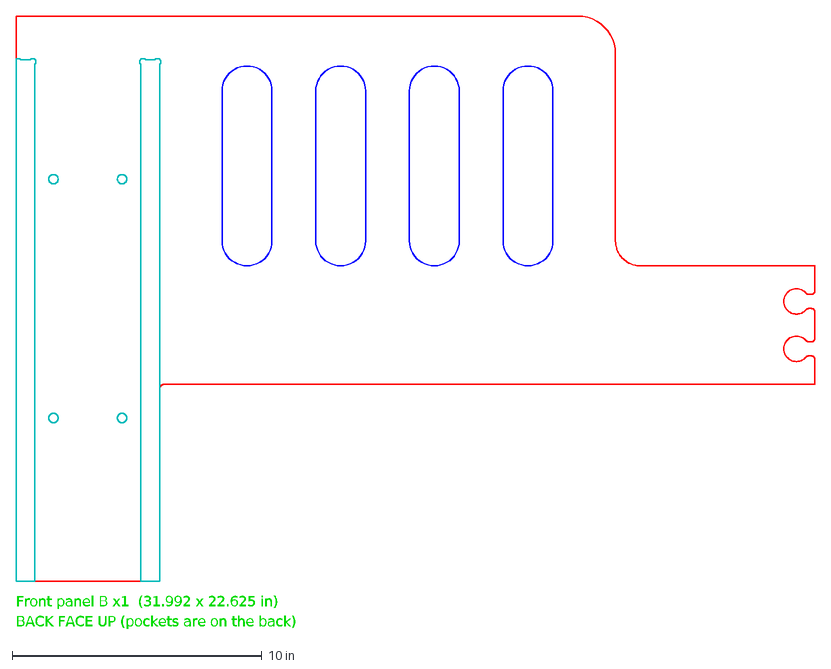
[picture p105: CAD file, 2026-10-17]
output/v3_raised_drawers/parts/front_panel_b.dxf
BACK FACE UP (pockets are on the back)
Front panel B x1 (31.992 x 22.625 in)
