mosschief/toddler_bed/output/v1c_side_exit_one_box_flush/parts/box_lid.dxf

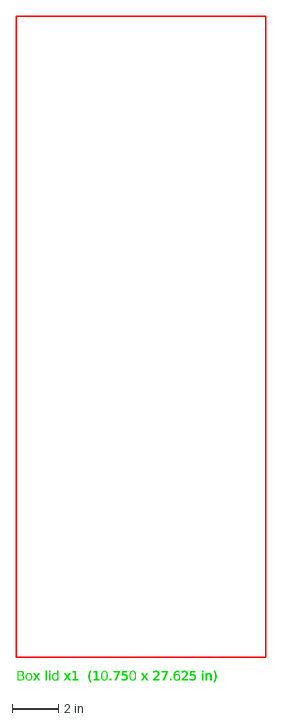
[picture p108: CAD file, 2026-10-17]
output/v1c_side_exit_one_box_flush/parts/box_lid.dxf
Box lid x1 (10.750 x 27.625 in)
