mosschief/toddler_bed/output/v1d_side_exit_one_box_flowers/parts/box_side_mattress.dxf

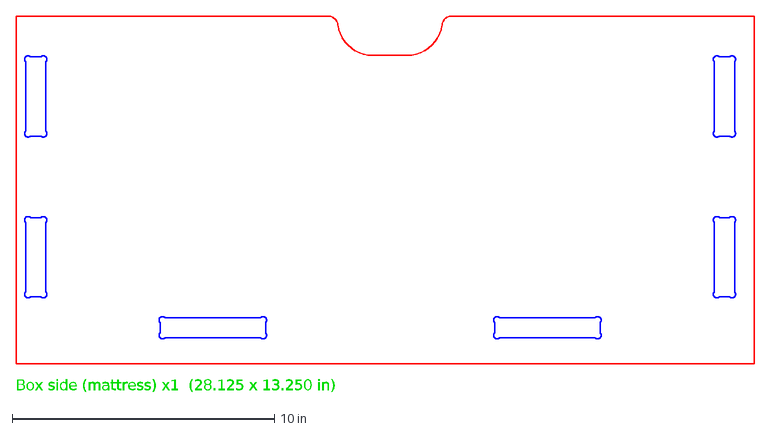
[picture p109: CAD file, 2026-10-17]
output/v1d_side_exit_one_box_flowers/parts/box_side_mattress.dxf
Box side (mattress) x1 (28.125 x 13.250 in)
