mosschief/toddler_bed/output/v1g_side_exit_foot_box_ferns/parts/box_side_mattress.dxf

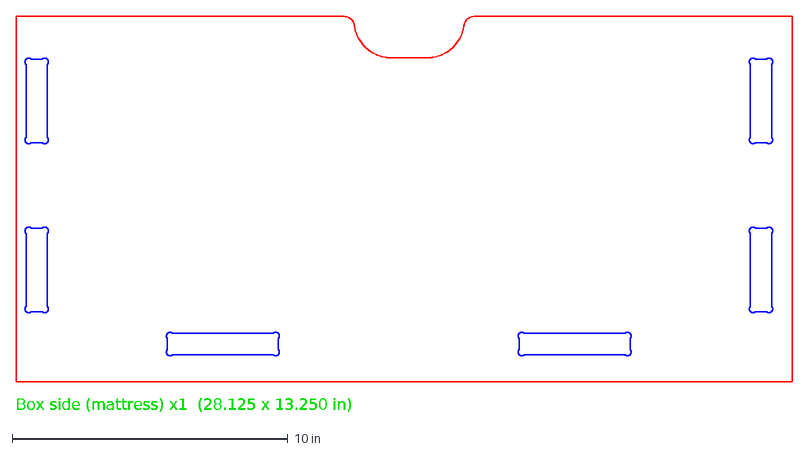
[picture p110: CAD file, 2026-10-17]
output/v1g_side_exit_foot_box_ferns/parts/box_side_mattress.dxf
Box side (mattress) x1 (28.125 x 13.250 in)
