mosschief/toddler_bed/output/v2_center_exit/parts/corner_block.dxf

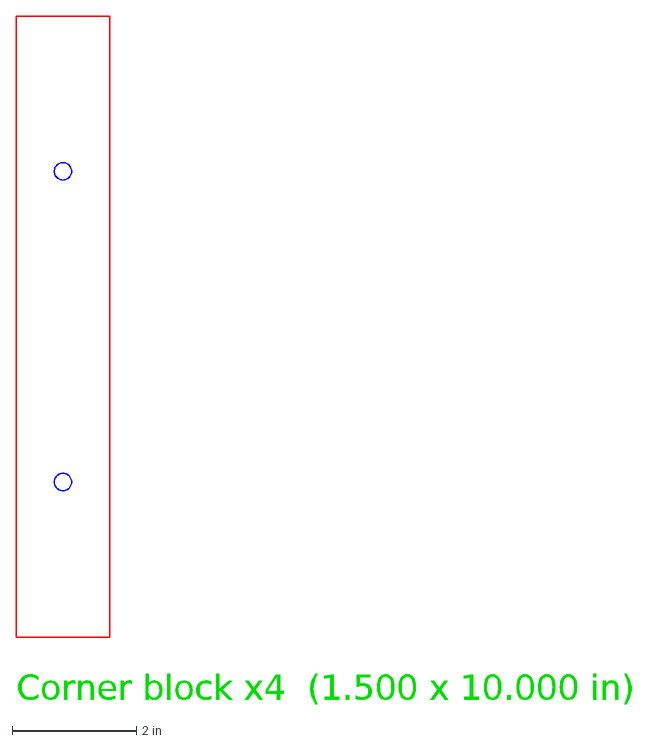
[picture p111: CAD file, 2026-10-10]
output/v2_center_exit/parts/corner_block.dxf
Corner block x4 (1.500 x 10.000 in)
