mosschief/toddler_bed/output/v3_raised_drawers/parts/deck_ledger_box_side.dxf

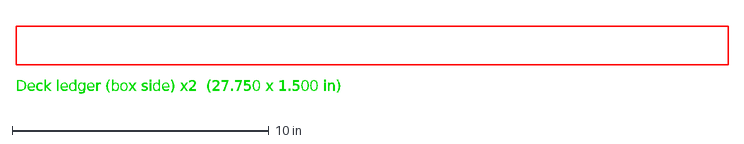
[picture p112: CAD file, 2026-10-17]
output/v3_raised_drawers/parts/deck_ledger_box_side.dxf
Deck ledger (box side) x2 (27.750 x 1.500 in)
