mosschief/toddler_bed/output/v1_side_exit/parts/box_side.dxf

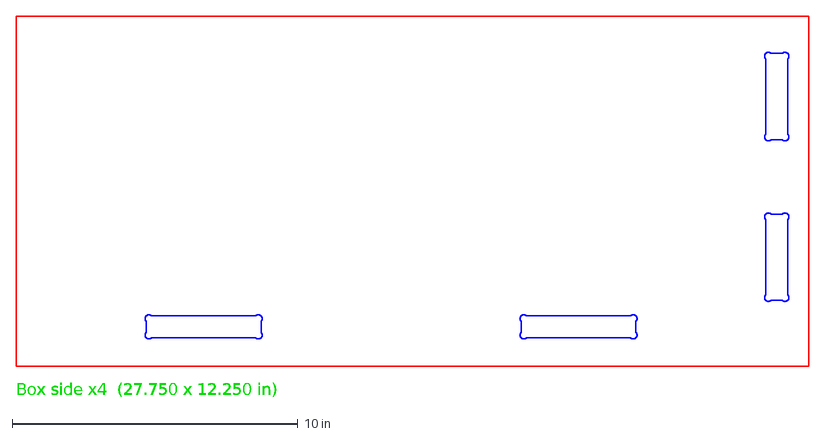
[picture p113: CAD file, 2026-10-10]
output/v1_side_exit/parts/box_side.dxf
Box side x4 (27.750 x 12.250 in)
