mosschief/toddler_bed/output/v1e_side_exit_foot_box/parts/head_block.dxf

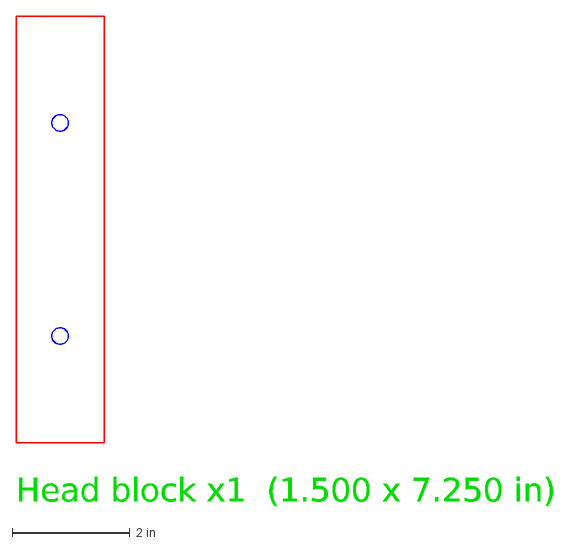
[picture p116: CAD file, 2026-10-17]
output/v1e_side_exit_foot_box/parts/head_block.dxf
Head block x1 (1.500 x 7.250 in)
