mosschief/toddler_bed/output/v1f_side_exit_foot_box_trees/parts/head_wall_liner.dxf

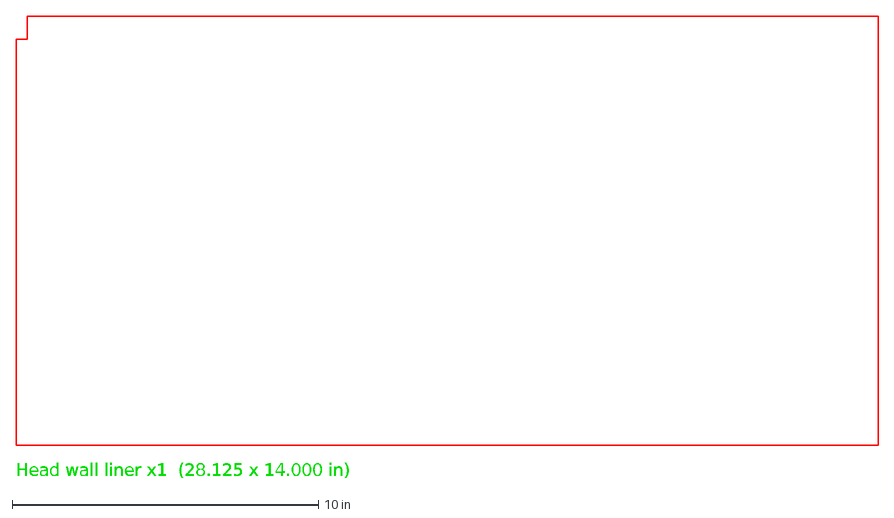
[picture p117: CAD file, 2026-10-17]
output/v1f_side_exit_foot_box_trees/parts/head_wall_liner.dxf
Head wall liner x1 (28.125 x 14.000 in)
