mosschief/toddler_bed/output/v1_side_exit/parts/box_bottom.dxf

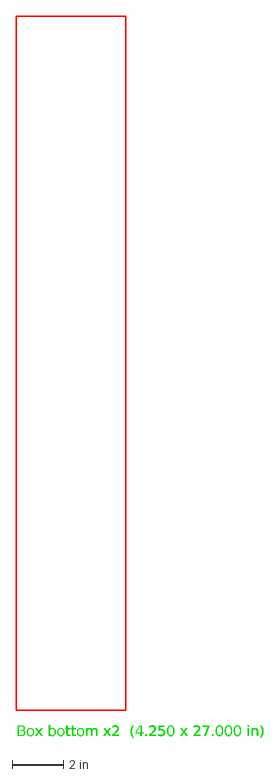
[picture p118: CAD file, 2026-10-09]
output/v1_side_exit/parts/box_bottom.dxf
Box bottom x2 (4.250 x 27.000 in)
