mosschief/toddler_bed/output/v1b_side_exit_one_box/parts/corner_block_foot.dxf

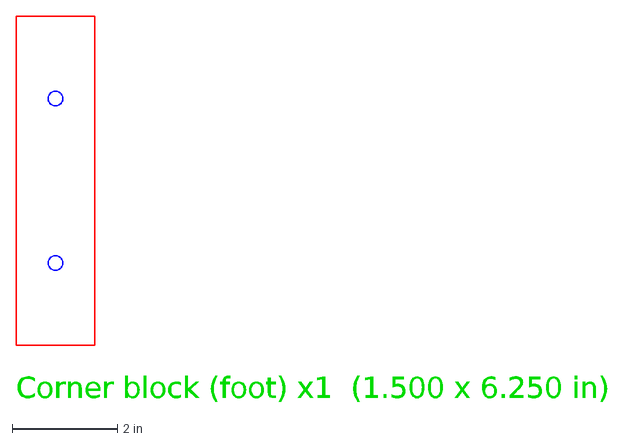
[picture p119: CAD file, 2026-10-12]
output/v1b_side_exit_one_box/parts/corner_block_foot.dxf
Corner block (foot) x1 (1.500 x 6.250 in)
