mosschief/toddler_bed/output/v2_center_exit/parts/box_bottom.dxf

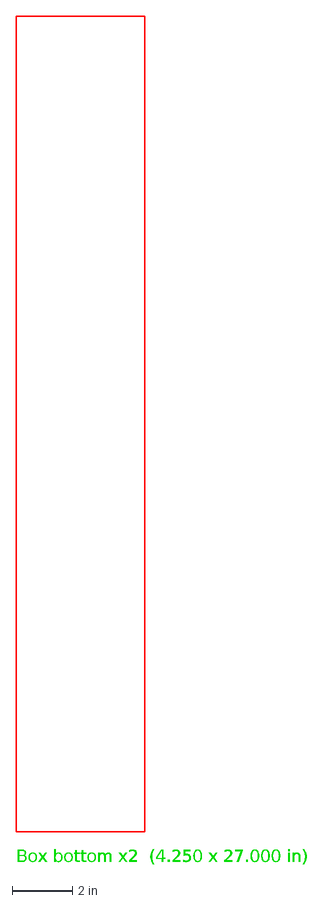
[picture p120: CAD file, 2026-10-09]
output/v2_center_exit/parts/box_bottom.dxf
Box bottom x2 (4.250 x 27.000 in)
