mosschief/toddler_bed/output/v1b_side_exit_one_box/parts/corner_block.dxf

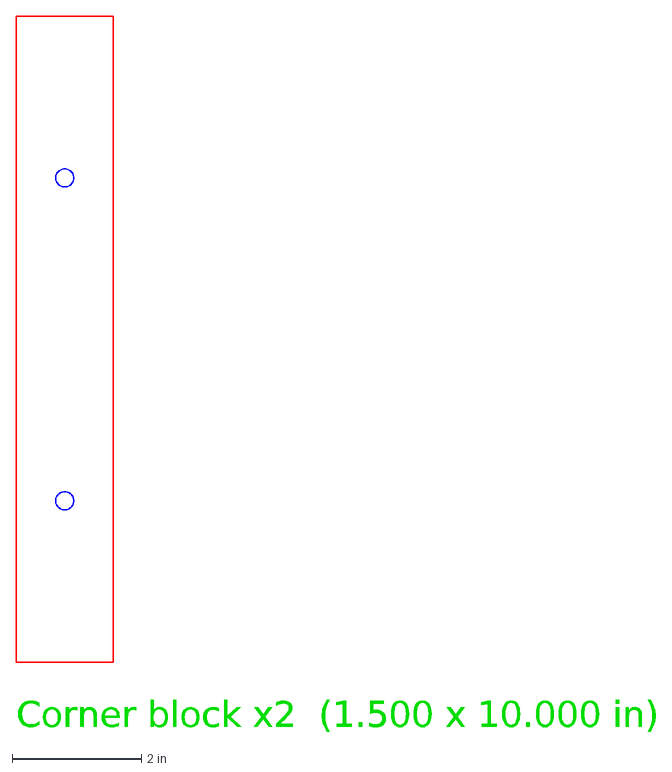
[picture p121: CAD file, 2026-10-12]
output/v1b_side_exit_one_box/parts/corner_block.dxf
Corner block x2 (1.500 x 10.000 in)
