mosschief/toddler_bed/output/v3_raised_drawers/parts/front_panel_a.dxf

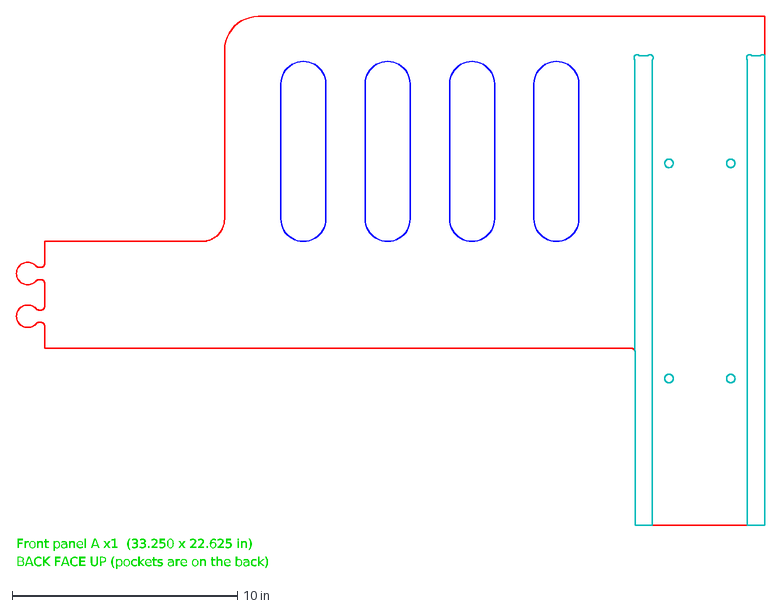
[picture p122: CAD file, 2026-10-17]
output/v3_raised_drawers/parts/front_panel_a.dxf
BACK FACE UP (pockets are on the back)
Front panel A x1 (33.250 x 22.625 in)
