mosschief/toddler_bed/output/v3_raised_drawers/parts/deck_ledger_wall.dxf

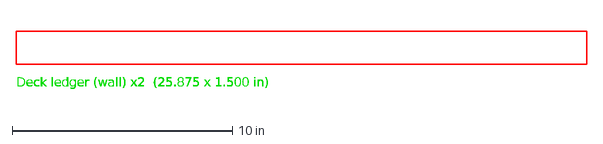
[picture p123: CAD file, 2026-10-17]
output/v3_raised_drawers/parts/deck_ledger_wall.dxf
Deck ledger (wall) x2 (25.875 x 1.500 in)
