mosschief/toddler_bed/output/v3_raised_drawers/parts/corner_block.dxf

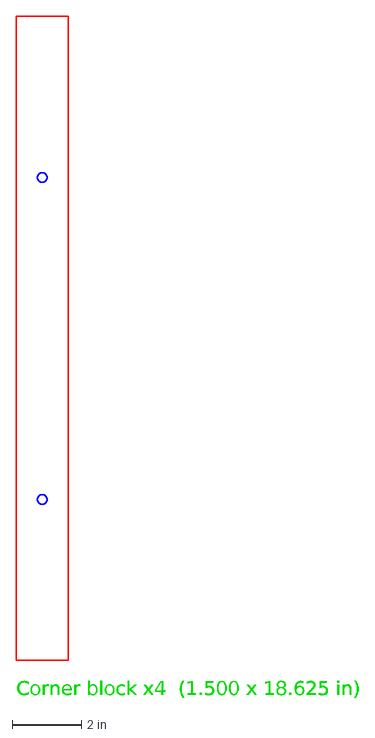
[picture p124: CAD file, 2026-10-10]
output/v3_raised_drawers/parts/corner_block.dxf
Corner block x4 (1.500 x 18.625 in)
