mosschief/toddler_bed/output/v3_raised_drawers/parts/box_side.dxf

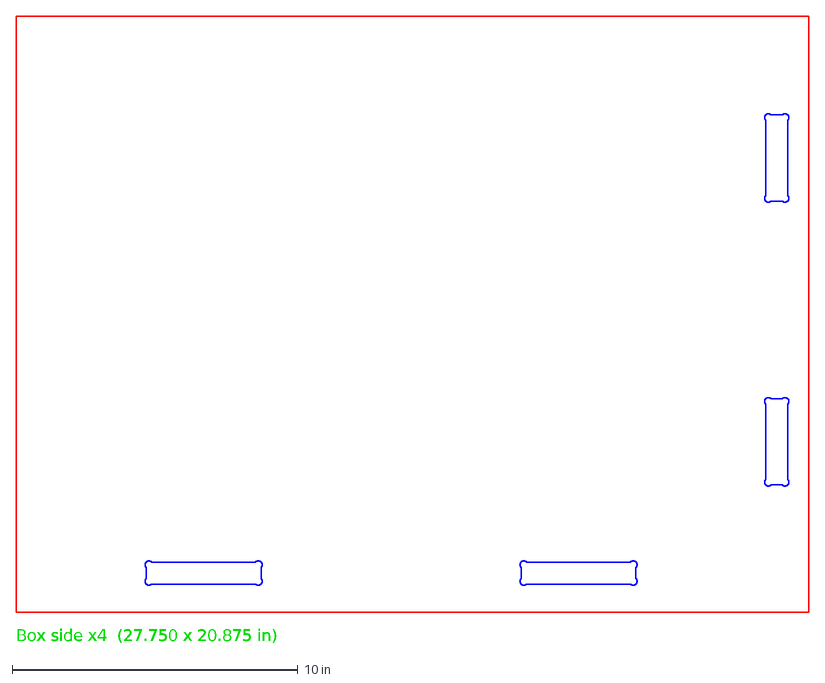
[picture p125: CAD file, 2026-10-10]
output/v3_raised_drawers/parts/box_side.dxf
Box side x4 (27.750 x 20.875 in)
