mosschief/toddler_bed/output/v3_raised_drawers/parts/box_bottom.dxf

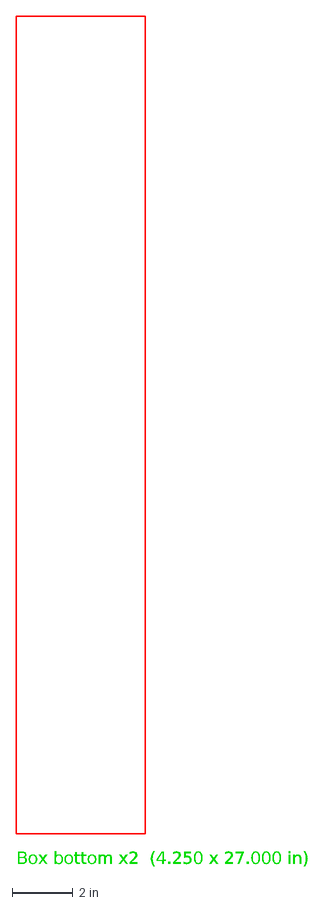
[picture p126: CAD file, 2026-10-09]
output/v3_raised_drawers/parts/box_bottom.dxf
Box bottom x2 (4.250 x 27.000 in)
