mosschief/toddler_bed/(list of files, cad)

Other CAD files:
output/v1_side_exit/sheets/panel_2.dxf
output/v1b_side_exit_one_box/sheets/panel_1.dxf
output/v1c_side_exit_one_box_flush/parts/front_panel_a.dxf
output/v1c_side_exit_one_box_flush/sheets/panel_1.dxf
output/v1d_side_exit_one_box_flowers/sheets/panel_1.dxf
output/v1d_side_exit_one_box_flowers/v1d_side_exit_one_box_flowers.step
output/v1e_side_exit_foot_box/sheets/panel_2.dxf
output/v1f_side_exit_foot_box_trees/sheets/panel_2.dxf
output/v1f_side_exit_foot_box_trees/v1f_side_exit_foot_box_trees.step
output/v1g_side_exit_foot_box_ferns/sheets/panel_2.dxf
output/v2_center_exit/sheets/panel_1.dxf
output/v3_raised_drawers/sheets/panel_4.dxf
output/v1_side_exit/sheets/panel_1.dxf
output/v1b_side_exit_one_box/sheets/panel_2.dxf
output/v1c_side_exit_one_box_flush/sheets/panel_2.dxf
output/v1d_side_exit_one_box_flowers/parts/front_panel_a.dxf
output/v1d_side_exit_one_box_flowers/sheets/panel_2.dxf
output/v1e_side_exit_foot_box/sheets/panel_1.dxf
output/v1f_side_exit_foot_box_trees/sheets/panel_1.dxf
output/v1g_side_exit_foot_box_ferns/sheets/panel_1.dxf
output/v2_center_exit/sheets/panel_2.dxf
output/v3_raised_drawers/sheets/panel_5.dxf
output/v1g_side_exit_foot_box_ferns/parts/front_panel_a.dxf
output/v3_raised_drawers/sheets/panel_3.dxf
output/v1_side_exit/parts/front_panel_a.dxf
output/v1f_side_exit_foot_box_trees/parts/front_panel_a.dxf
output/v3_raised_drawers/sheets/panel_1.dxf
output/v1f_side_exit_foot_box_trees/parts/box_side_wall.dxf
output/v1g_side_exit_foot_box_ferns/parts/box_side_wall.dxf
output/v3_raised_drawers/sheets/panel_2.dxf
output/v1b_side_exit_one_box/parts/box_lid.dxf
output/v1d_side_exit_one_box_flowers/parts/foot_wall_liner.dxf
output/v1g_side_exit_foot_box_ferns/parts/box_lid.dxf
output/v1b_side_exit_one_box/parts/box_floor.dxf
output/v1e_side_exit_foot_box/parts/front_panel_a.dxf
output/v1g_side_exit_foot_box_ferns/parts/head_wall_liner.dxf
output/v1d_side_exit_one_box_flowers/parts/box_floor.dxf
output/v1e_side_exit_foot_box/parts/box_floor.dxf
output/v1f_side_exit_foot_box_trees/parts/box_floor.dxf
output/v1b_side_exit_one_box/parts/front_panel_a.dxf
output/v1g_side_exit_foot_box_ferns/parts/box_floor.dxf
output/v2_center_exit/parts/box_side.dxf
output/v3_raised_drawers/parts/box_lid.dxf
output/v3_raised_drawers/parts/box_floor.dxf
