mosschief/toddler_bed/(commit log)

2026-10-09 Parametric CNC toddler bed: three variants with DXF cut files, nesting and previews
    Claude-Session: https://claude.ai/code/session_012eV67E8oNNy7yXGSGka4UX
    [box_back.dxf, box_bottom.dxf, box_lid.dxf, box_side.dxf, centre_divider.dxf, deck.dxf, deck_ledger_box_side.dxf, deck_ledger_wall.dxf]
2026-10-10 Full design for the side-exit floor bed: STEP model, drawings PDF, box joinery and nicer lids
    - 12 narrower rail slots (1-1/4" with 1" slats) instead of 8 wide ones
    - Lids split into a fixed hinge strip and an opening lid with rounded
    corners and a centred hand hole
    - Boxes joined with dog-boned tab-and-slot joints, raised floor, back
    inset for scribing to the wall
    - STEP assembly export and a multi-page drawings PDF for v1
    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
    [box_back.dxf, box_floor.dxf, box_lid.dxf, box_side.dxf, centre_divider.dxf, deck.dxf, deck_ledger_box_side.dxf, deck_ledger_wall.dxf]
2026-10-10 README: current slot size
    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
2026-10-10 Box lids hinge along the wall-side edge; hand cut-out moves to the mattress-side panel
    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
    [box_back.dxf, box_floor.dxf, box_lid.dxf, box_side_mattress.dxf, box_side_wall.dxf, centre_divider.dxf, deck.dxf, deck_ledger_box_side.dxf]
2026-10-10 One-piece box lids hinged on the wall-side edge; restore original 2" rail slots
    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
    [box_back.dxf, box_floor.dxf, box_lid.dxf, box_side_mattress.dxf, box_side_wall.dxf, centre_divider.dxf, deck.dxf, deck_ledger_box_side.dxf]
2026-10-10 Square box lid corners to match the boxes
    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
    [box_back.dxf, box_floor.dxf, box_lid.dxf, box_side_mattress.dxf, box_side_wall.dxf, centre_divider.dxf, deck.dxf, deck_ledger_box_side.dxf]
2026-10-10 Lower exit floor and slot bottoms to 1" below the mattress top so its edge shows
    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
    [box_back.dxf, box_floor.dxf, box_lid.dxf, box_side_mattress.dxf, box_side_wall.dxf, centre_divider.dxf, deck.dxf, deck_ledger_box_side.dxf]
2026-10-10 Drawings: dogbone detail for the front-panel grooves
    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
    [box_back.dxf, box_floor.dxf, box_lid.dxf, box_side_mattress.dxf, box_side_wall.dxf, centre_divider.dxf, deck.dxf, deck_ledger_box_side.dxf]
2026-10-10 Removable front panel: dog-boned grooves for the box sides, corner blocks bolted to threaded inserts
    - Box sides run 3/8" into grooves pocketed in the back of the front panel
    (open at the bottom, dog-boned at the top)
    - Corner blocks inside each box, bolted into threaded inserts in the panel
    - Pockets exported on POCKET_<depth> layers; pocketed parts mirrored so they
    cut back face up; STEP subtracts the pockets
    - Dogbone detail, hardware and assembly steps updated
    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
    [box_back.dxf, box_floor.dxf, box_lid.dxf, box_side_mattress.dxf, box_side_wall.dxf, centre_divider.dxf, corner_block.dxf, deck.dxf]
2026-10-10 Replace corner blocks with a tabbed front wall on each box
    Each storage box gets a front wall cut like the box back: tabbed through
    slots in both sides, sitting against the back of the front panel, with four
    bolt holes into the panel's threaded inserts. This drops the corner blocks
    and pocket screws. The box floor now runs from the front wall to the back.
    [box_back.dxf, box_floor.dxf, box_front.dxf, box_lid.dxf, box_side_mattress.dxf, box_side_wall.dxf, centre_divider.dxf, deck.dxf]
2026-10-12 Add a one-box side-exit variant (head box only, foot-wall liner)
    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
    [box_back.dxf, box_floor.dxf, box_front.dxf, box_lid.dxf, box_side_mattress.dxf, box_side_wall.dxf, centre_divider.dxf, corner_block.dxf]
2026-10-12 Add a one-box variant with lid and foot board flush with the rail top
    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
    [box_back.dxf, box_floor.dxf, box_front.dxf, box_lid.dxf, box_side_mattress.dxf, box_side_wall.dxf, centre_divider.dxf, deck.dxf]
2026-10-12 Add flower cut-outs as a rail option and a one-box flowers variant
    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
    [box_back.dxf, box_floor.dxf, box_front.dxf, box_lid.dxf, box_side_mattress.dxf, box_side_wall.dxf, centre_divider.dxf, deck.dxf]
2026-10-12 Add a one-box variant with the box at the foot end
    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
    [box_back.dxf, box_floor.dxf, box_front.dxf, box_lid.dxf, box_side_mattress.dxf, box_side_wall.dxf, centre_divider.dxf, deck.dxf]
2026-10-12 Make the foot-box bed the chosen design; add a staggered tree-line variant
    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
    [box_back.dxf, box_floor.dxf, box_front.dxf, box_lid.dxf, box_side_mattress.dxf, box_side_wall.dxf, centre_divider.dxf, deck.dxf]
2026-10-12 Add fern-frond rail cut-outs and a foot-box ferns variant
    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
    [box_back.dxf, box_floor.dxf, box_front.dxf, box_lid.dxf, box_side_mattress.dxf, box_side_wall.dxf, centre_divider.dxf, deck.dxf]
2026-10-12 Redraw fern fronds to match the reference: taller, denser oval leaflets
    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
    [box_back.dxf, box_floor.dxf, box_front.dxf, box_lid.dxf, box_side_mattress.dxf, box_side_wall.dxf, centre_divider.dxf, deck.dxf]
2026-10-12 Ferns: curved oblong leaflets only, frond tips curl alternately left and right
    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
    [box_back.dxf, box_floor.dxf, box_front.dxf, box_lid.dxf, box_side_mattress.dxf, box_side_wall.dxf, centre_divider.dxf, deck.dxf]
2026-10-12 Ferns: larger fronds with longer, wider leaflets and less wood between them
    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
    [box_back.dxf, box_floor.dxf, box_front.dxf, box_lid.dxf, box_side_mattress.dxf, box_side_wall.dxf, centre_divider.dxf, deck.dxf]
2026-10-12 Ferns: plumper oval leaflets and a short round stem, closer to the reference
    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
    [box_back.dxf, box_floor.dxf, box_front.dxf, box_lid.dxf, box_side_mattress.dxf, box_side_wall.dxf, centre_divider.dxf, deck.dxf]
2026-10-12 README: lock in the fern bed as the alternative to the straight-slot bed
    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
2026-10-12 Add a ferns + curly grass (fiddlehead) variant alongside the fern bed
    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
    [box_back.dxf, box_floor.dxf, box_front.dxf, box_lid.dxf, box_side_mattress.dxf, box_side_wall.dxf, centre_divider.dxf, deck.dxf]
2026-10-13 Curlier grass in the fiddlehead variant (v1h)
    Each grass tuft is now a tall wavy stalk rolling into a big spiral plus
    two pairs of shorter stalks that lean out and roll into their own
    spirals. Coil turns stop before the eye pinches below the 1/4" web.
    Fern leaflets that have no room beside the grass no longer hang the
    generator. v1g ferns output is unchanged.
    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
    [box_back.dxf, box_floor.dxf, box_front.dxf, box_lid.dxf, box_side_mattress.dxf, box_side_wall.dxf, front_panel_a.dxf, front_panel_b.dxf]
2026-10-13 Drop the ferns + curly grass variant (v1h)
    Sean preferred the original fern fronds (v1g), which stay unchanged.
    Keeps the guard that stops a crowded frond leaflet from looping forever.
    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
    [box_back.dxf, box_floor.dxf, box_front.dxf, box_lid.dxf, box_side_mattress.dxf, box_side_wall.dxf, front_panel_a.dxf, front_panel_b.dxf]
2026-10-17 Hardware list: inserts up to 1/2" long, 1-1/4" bolts
    The insert pockets are 1/2" deep, so 1/2" inserts fit; 1" bolts only
    reached ~3/16" into the insert through the 3/4" box front.
    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
    [box_back.dxf, box_floor.dxf, box_front.dxf, box_lid.dxf, box_side_mattress.dxf, box_side_wall.dxf, centre_divider.dxf, deck.dxf]
2026-10-31 Add lid hinge plan: install steps, CNC cup-pocket DXF and job spec
    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
    [lid_hinge_cups.dxf]
